VoxelPi/AX08/readme.md

# AX08
Design documents for the AX08 computer, an axiom architecture.

> [!CAUTION]
> The AX08 computer architecture is still highly experimental.
