VoxelPi/AX08/images/AX08.png

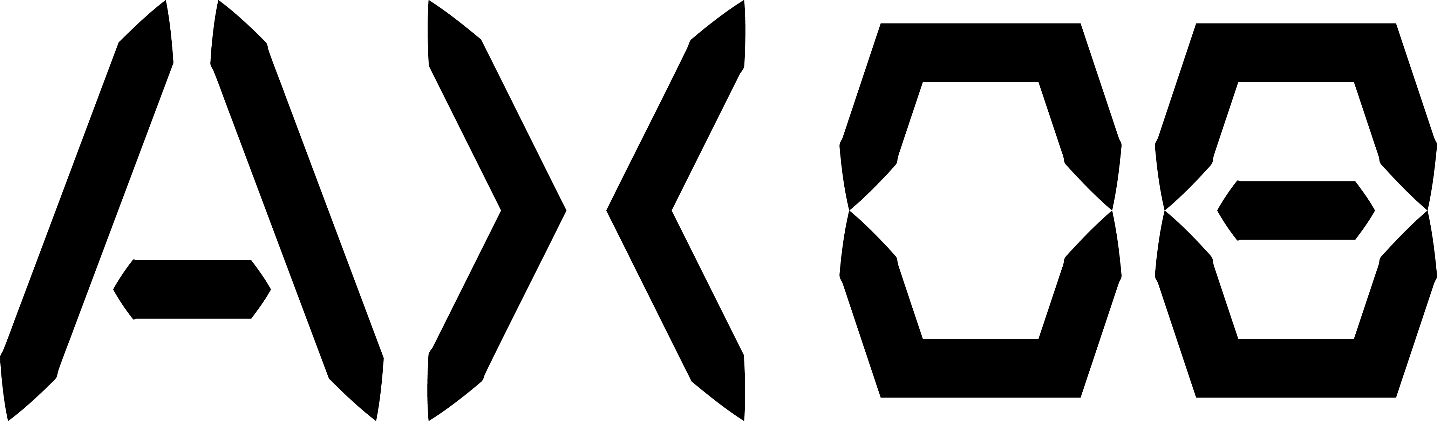
images/AX08.png
