VoxelPi/AX08/images/axiom.png

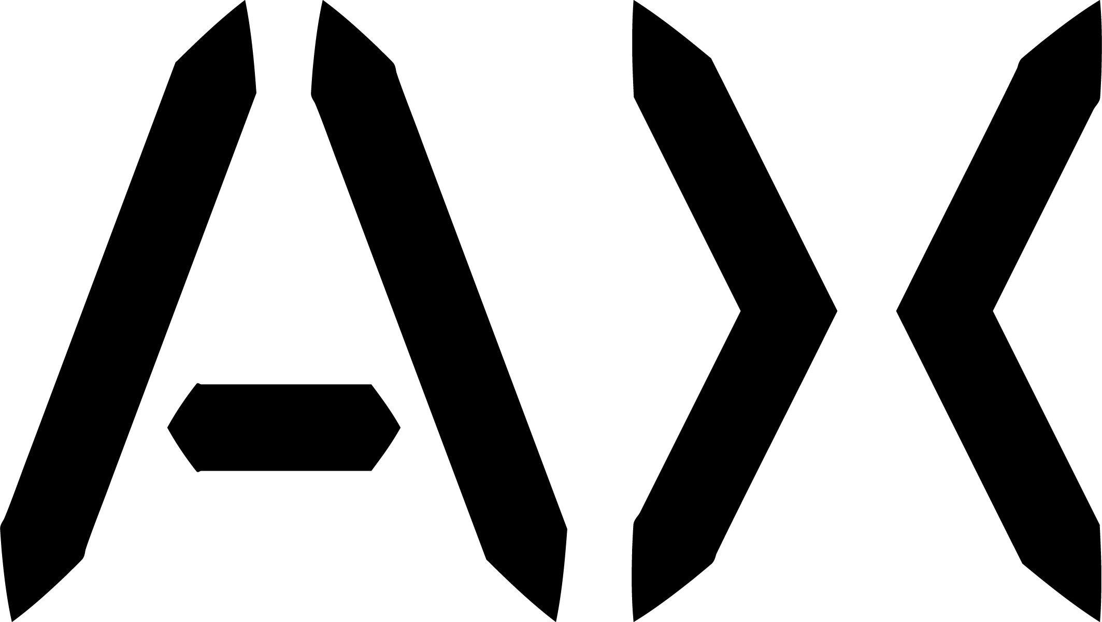
images/axiom.png
