VoxelPi/AX08/images/baud_rate.png

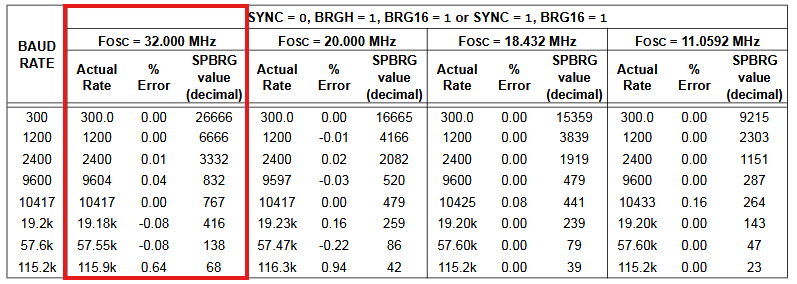
images/baud_rate.png
