VoxelPi/AX08/images/sequencer/sequencer_v0_clock_0_18kHz.png

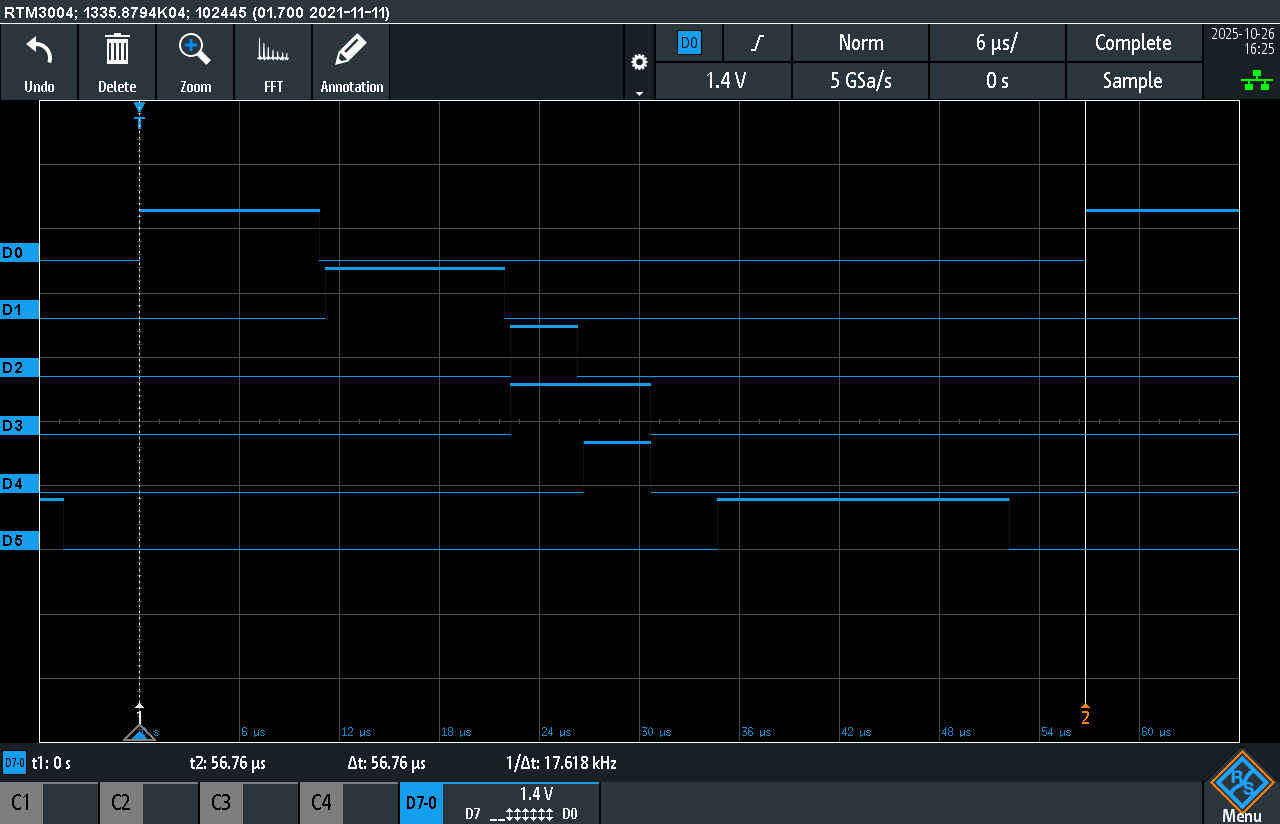
images/sequencer/sequencer_v0_clock_0_18kHz.png
