VoxelPi/AX08/images/sequencer/sequencer_v0_clock_1_7Hz.png

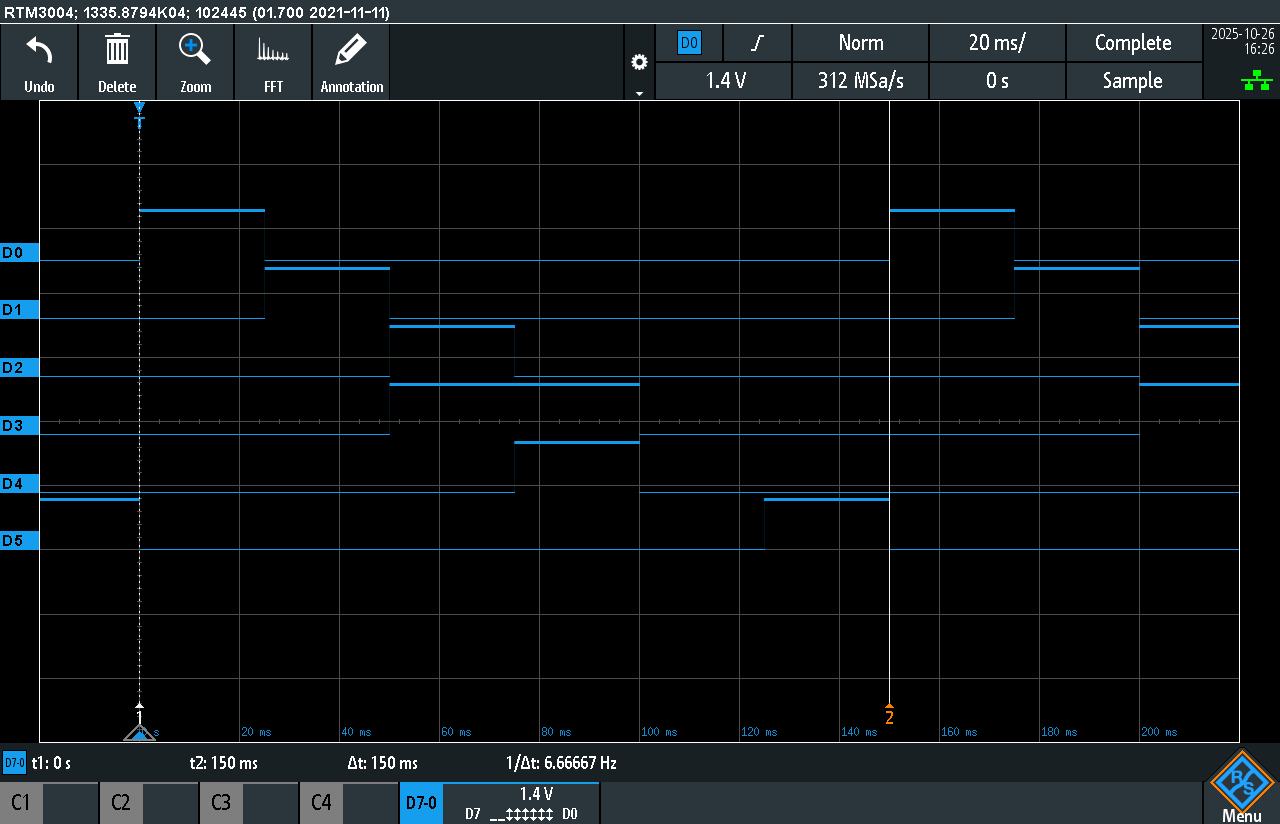
images/sequencer/sequencer_v0_clock_1_7Hz.png
