VoxelPi/AX08/images/sequencer/sequencer_v1_clock_0_20kHz.png

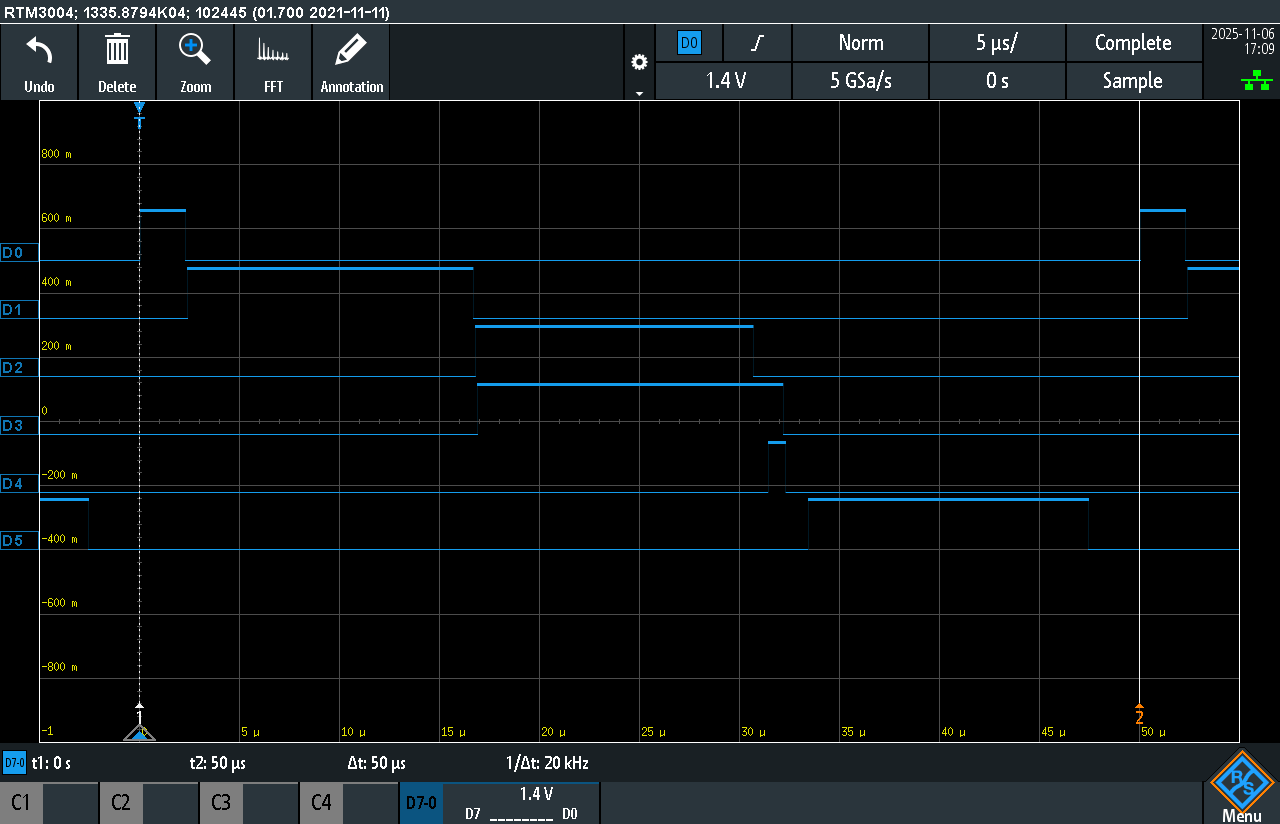
images/sequencer/sequencer_v1_clock_0_20kHz.png
