VoxelPi/AX08/images/sequencer/sequencer_v1_clock_1_1kHz.png

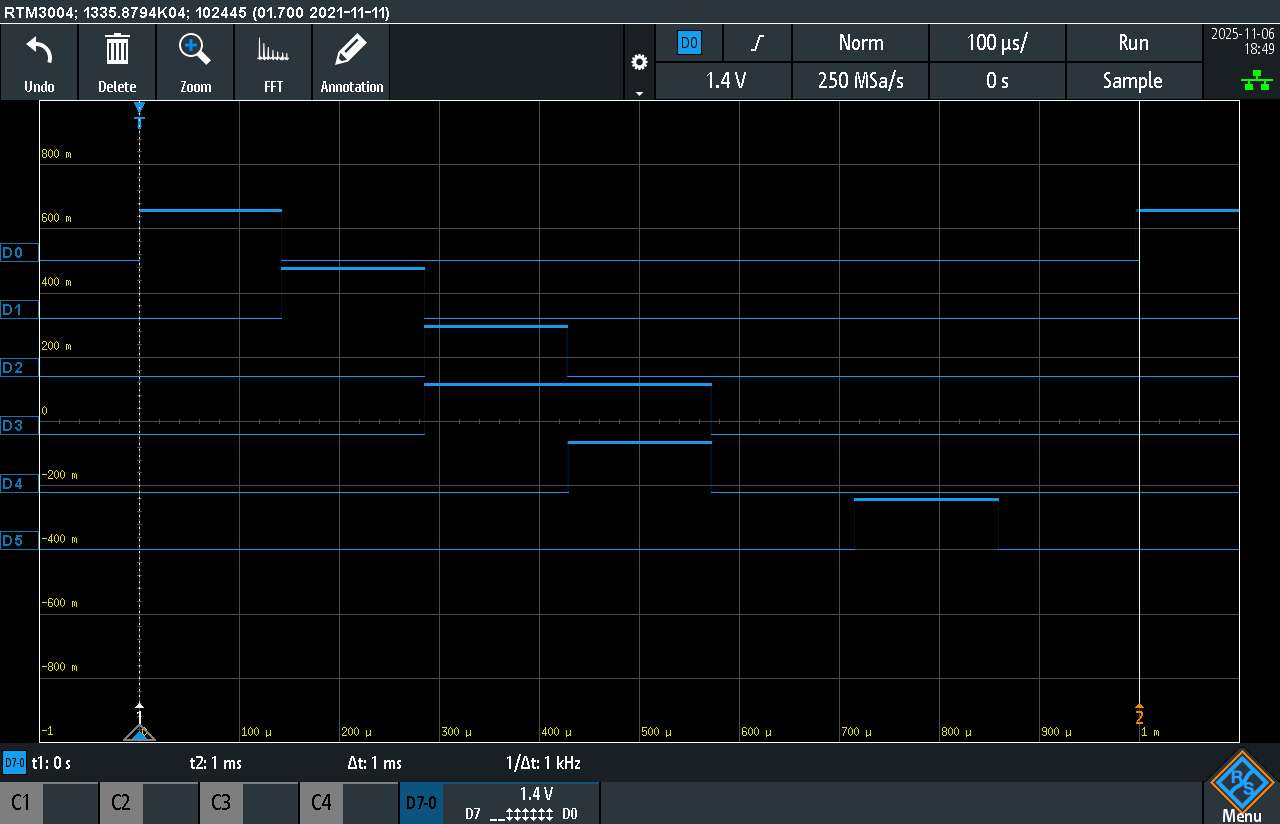
images/sequencer/sequencer_v1_clock_1_1kHz.png
