VoxelPi/AX08/images/sequencer_v0_timings.png

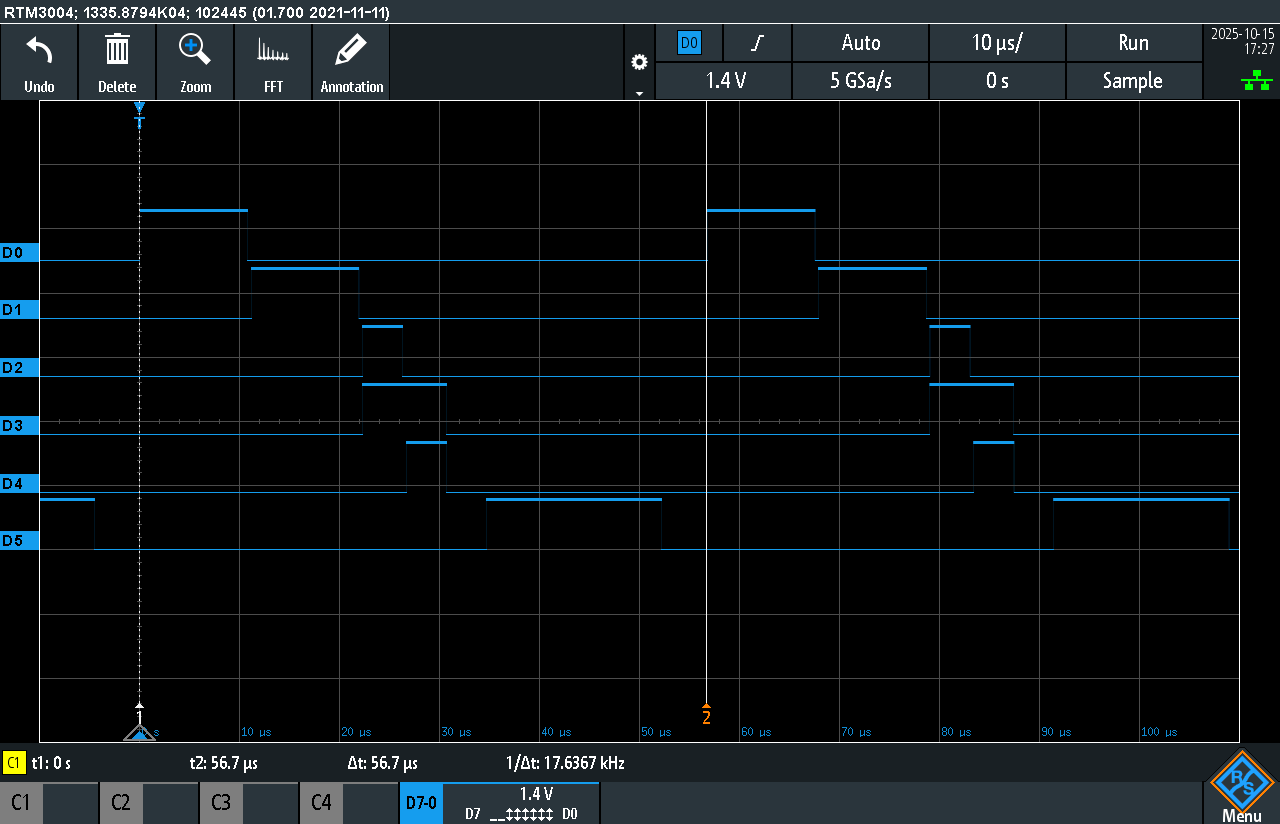
images/sequencer_v0_timings.png
