VoxelPi/AX08/schematic drafts/almost a stack.png

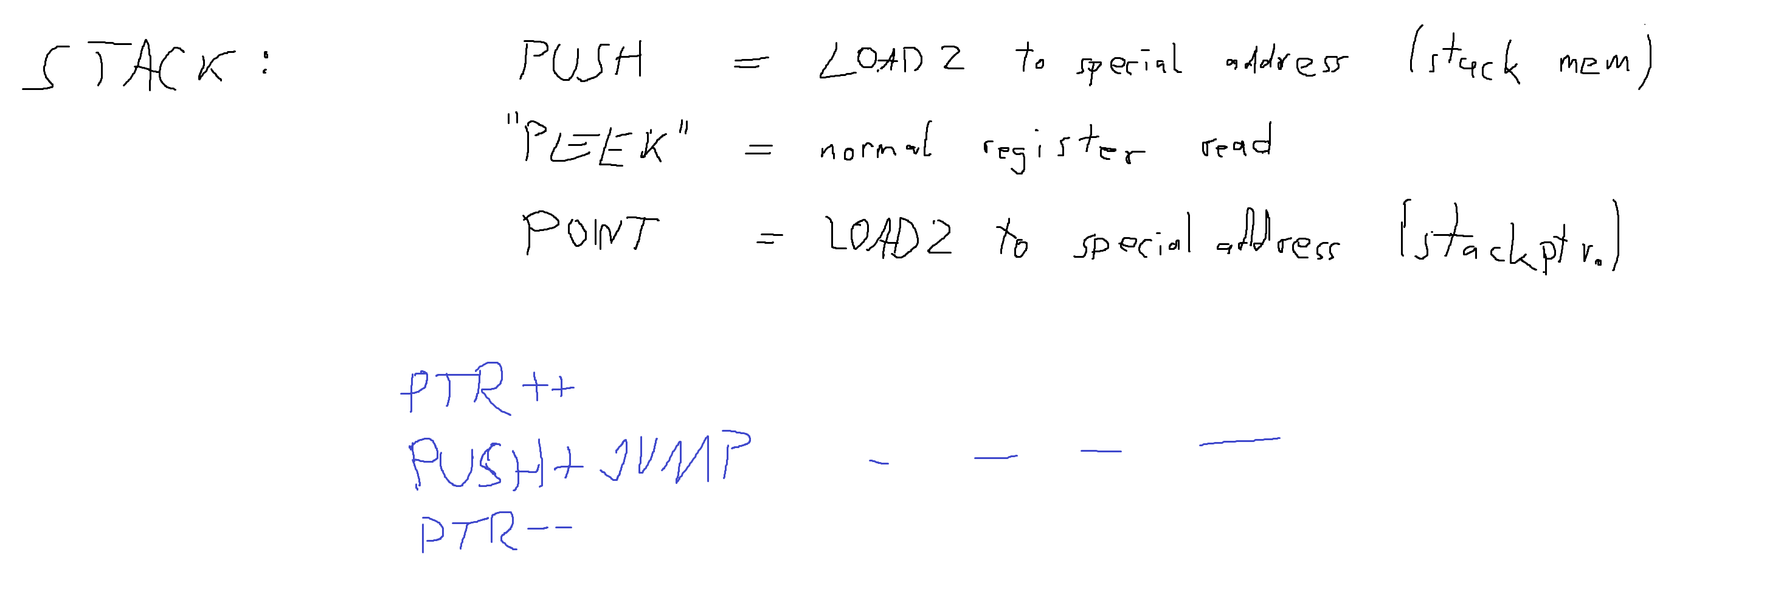
schematic drafts/almost a stack.png
