VoxelPi/AX08/schematic drafts/axiom_family.png

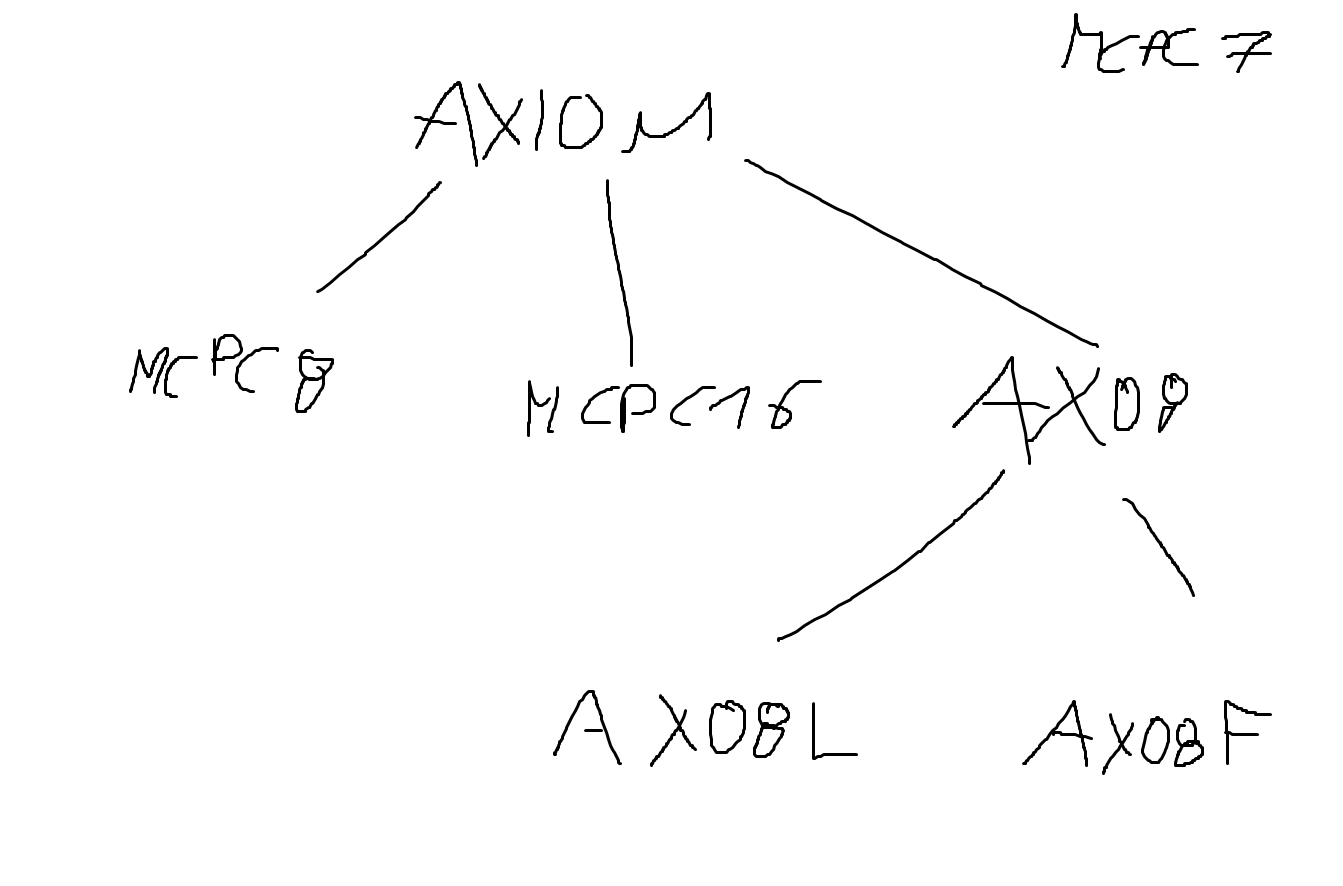
schematic drafts/axiom_family.png
