VoxelPi/AX08/schematic drafts/carry.exe.png

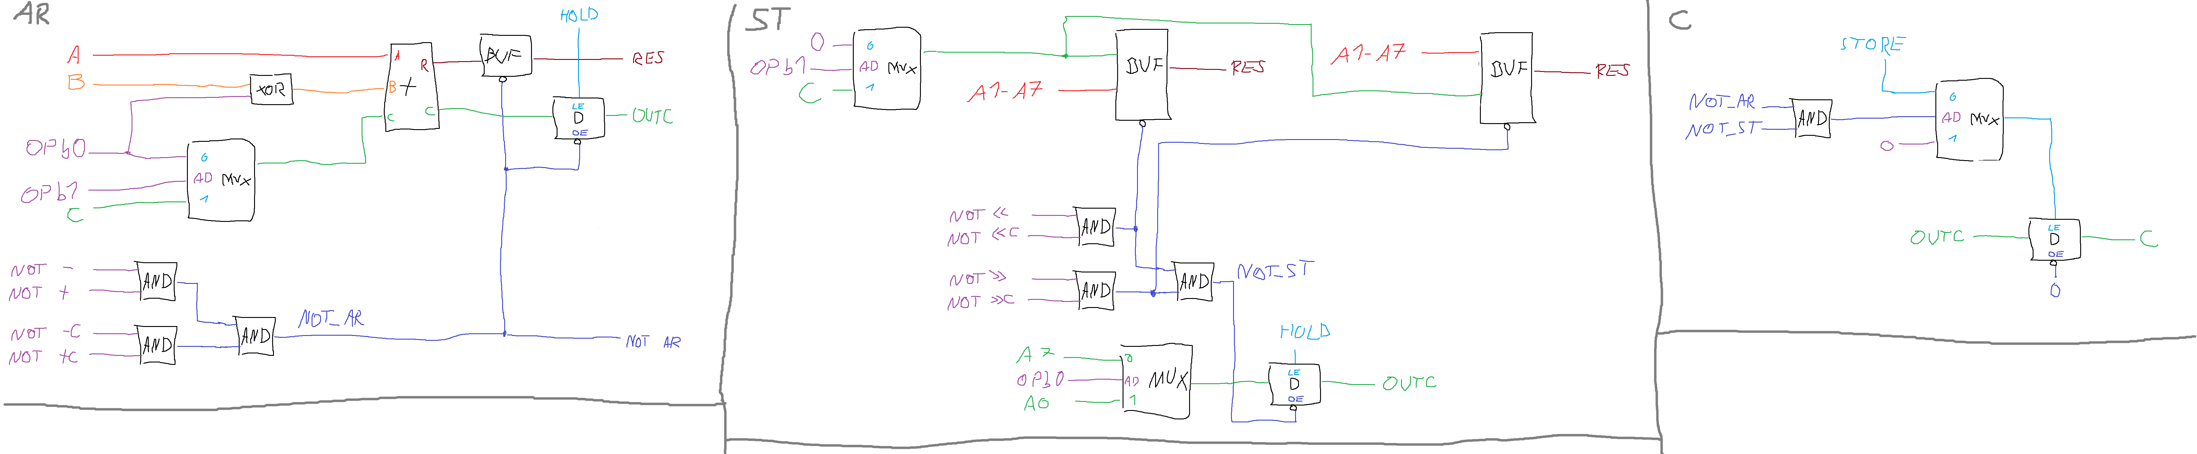
schematic drafts/carry.exe.png
