VoxelPi/AX08/schematic drafts/case_lid.png

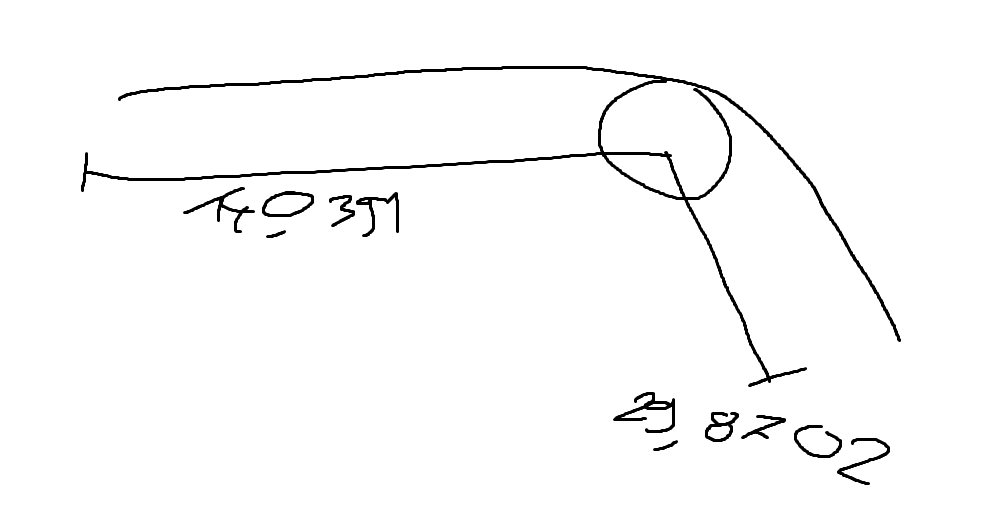
schematic drafts/case_lid.png
