VoxelPi/AX08/schematic drafts/fast_cycle.png

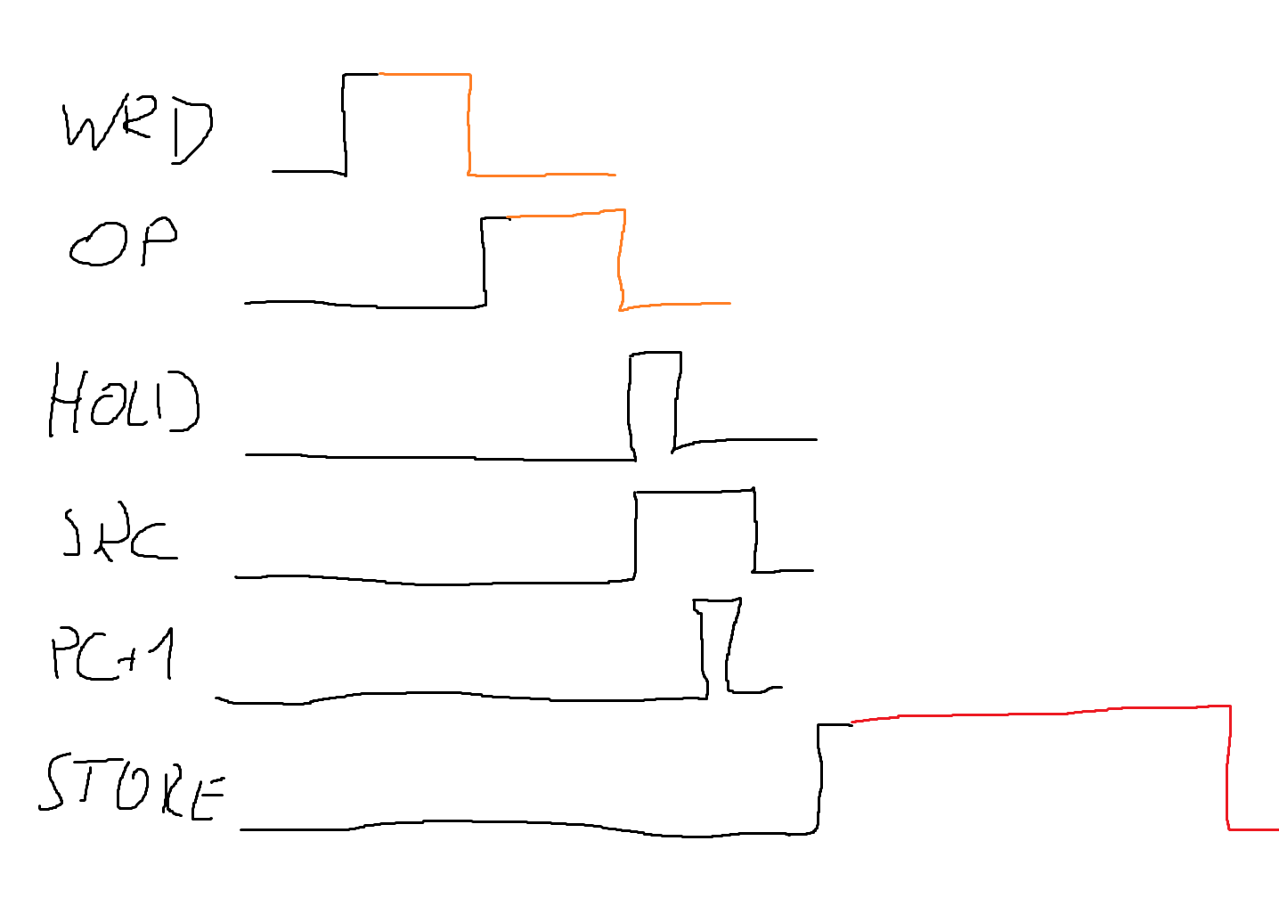
schematic drafts/fast_cycle.png
