VoxelPi/AX08/schematic drafts/frontpanel_v2.png

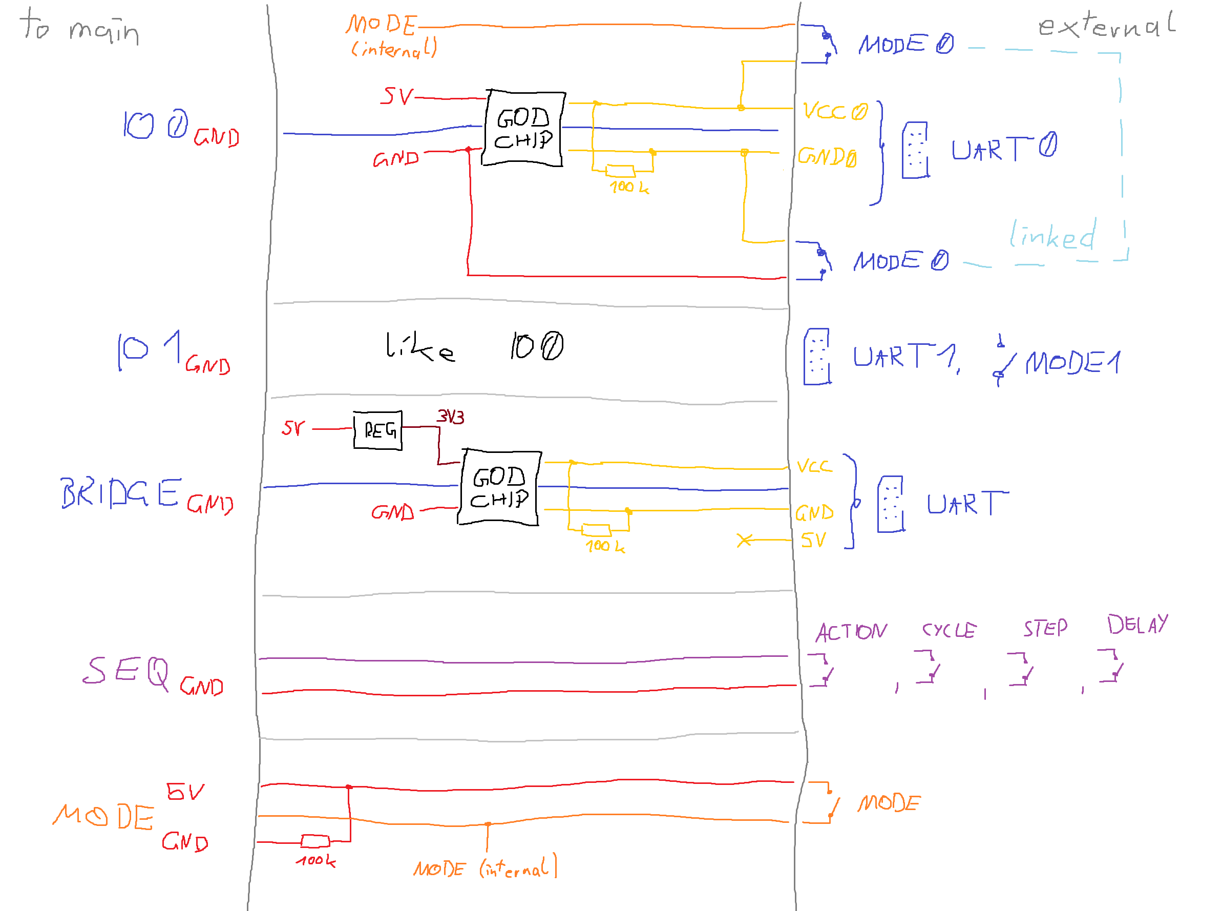
schematic drafts/frontpanel_v2.png
