VoxelPi/AX08/schematic drafts/general architecture.png

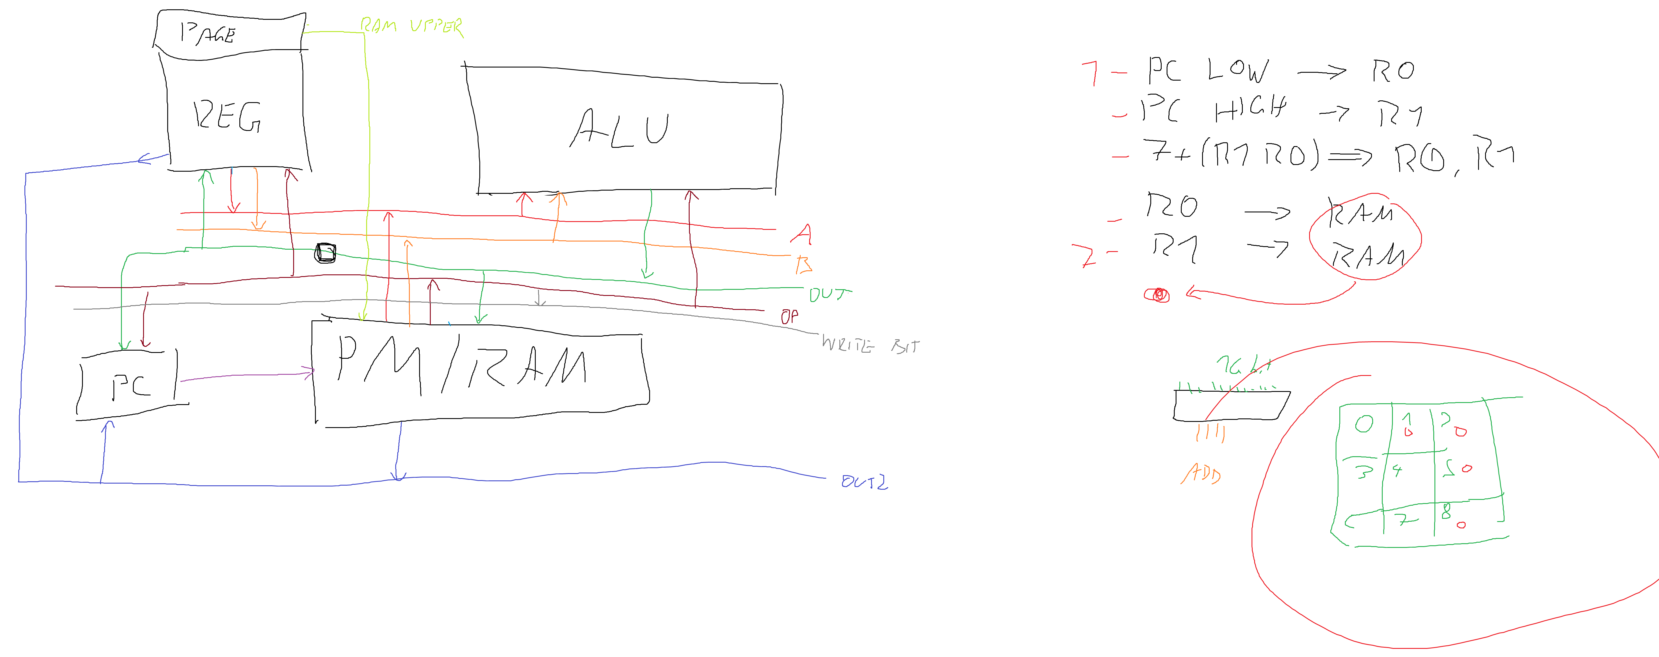
schematic drafts/general architecture.png
