VoxelPi/AX08/schematic drafts/hold unit.png

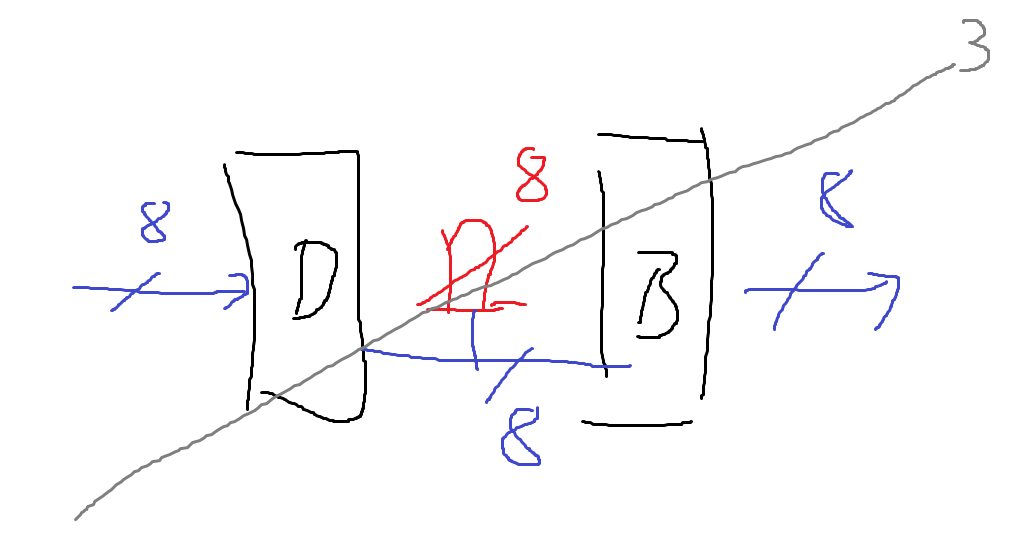
schematic drafts/hold unit.png
