VoxelPi/AX08/schematic drafts/io_unit.png

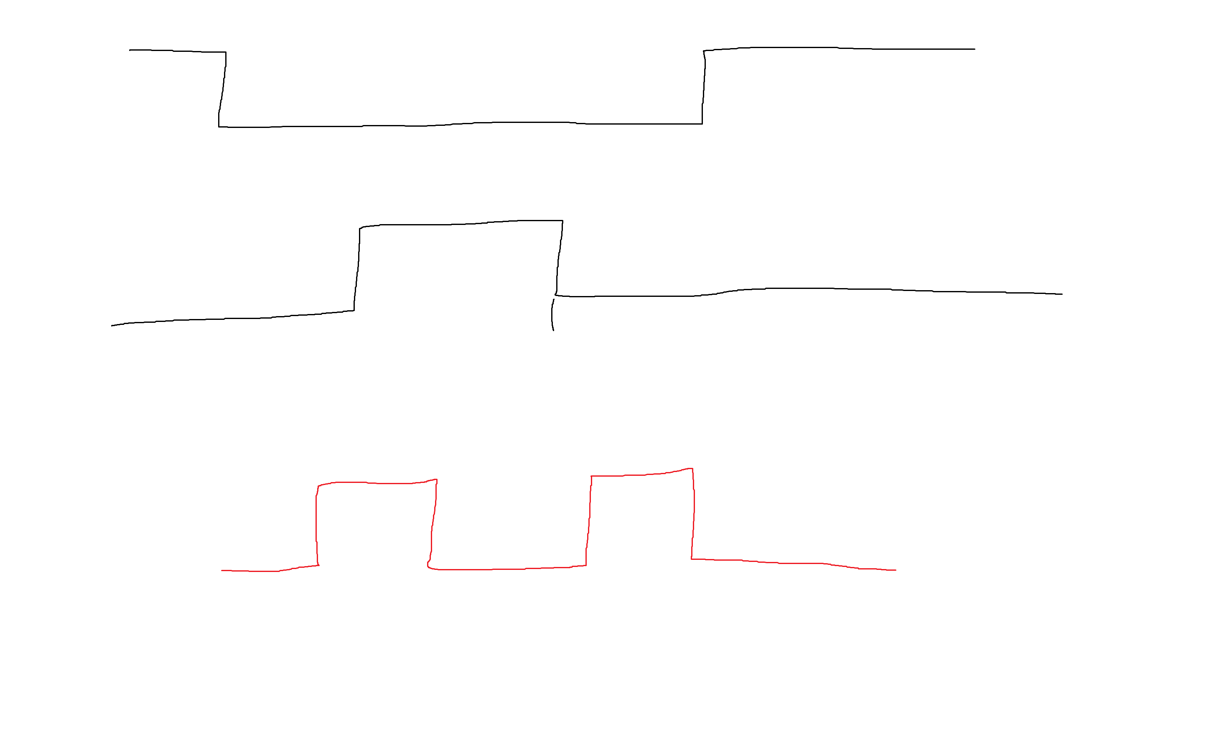
schematic drafts/io_unit.png
