VoxelPi/AX08/schematic drafts/io_unit_v2.png

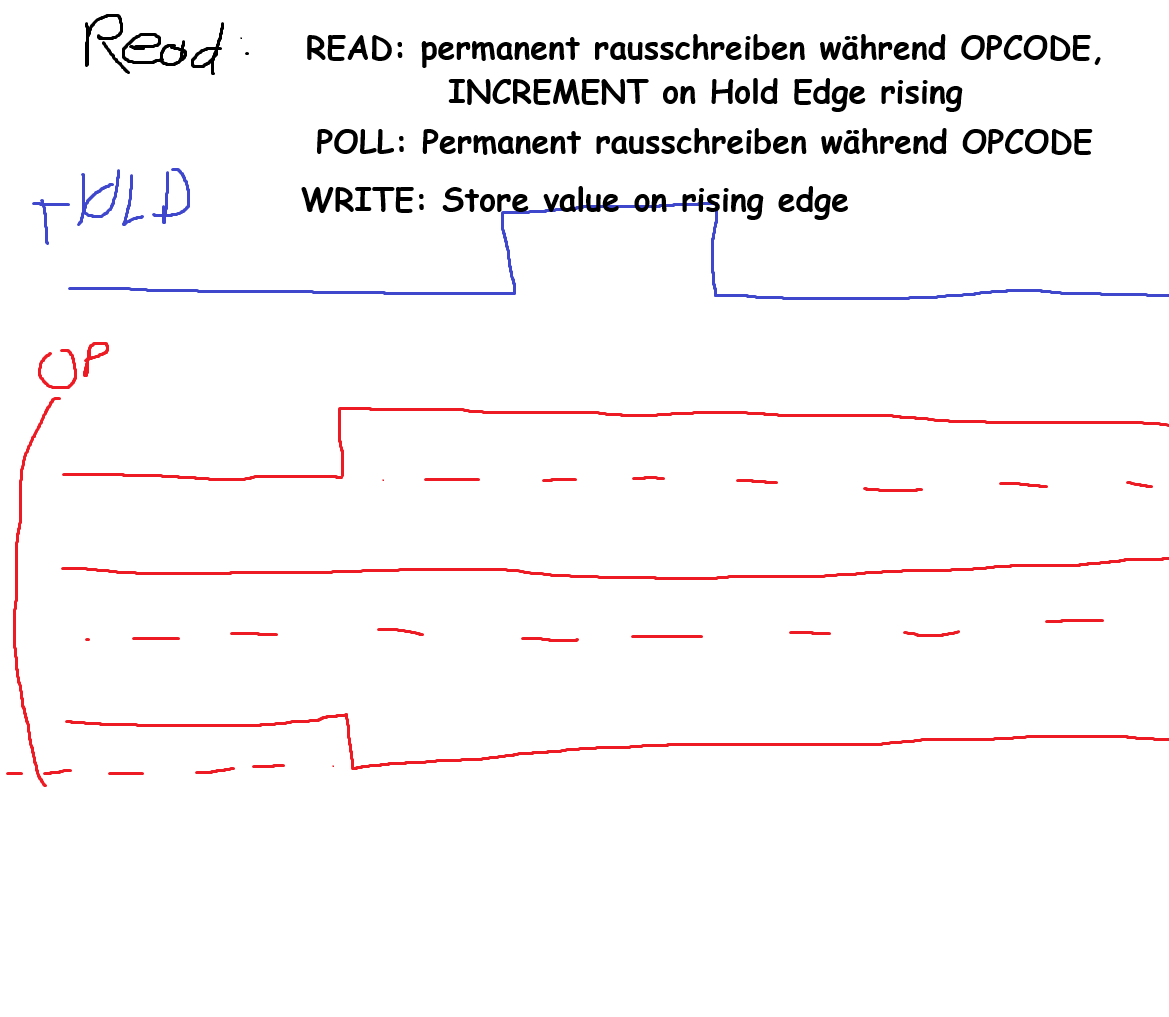
schematic drafts/io_unit_v2.png
