VoxelPi/AX08/schematic drafts/page.png

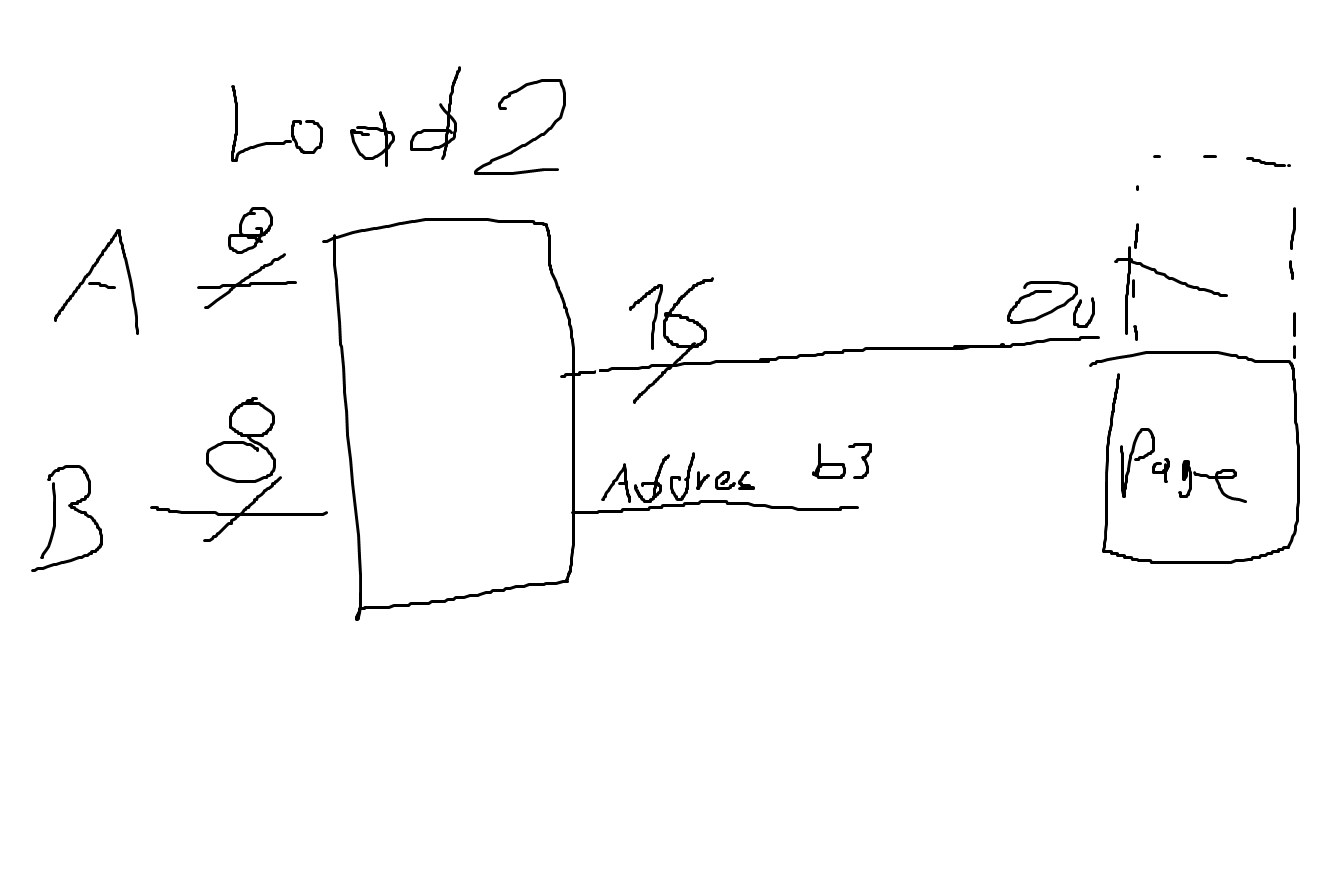
schematic drafts/page.png
