VoxelPi/AX08/schematic drafts/pc_address_logic.png

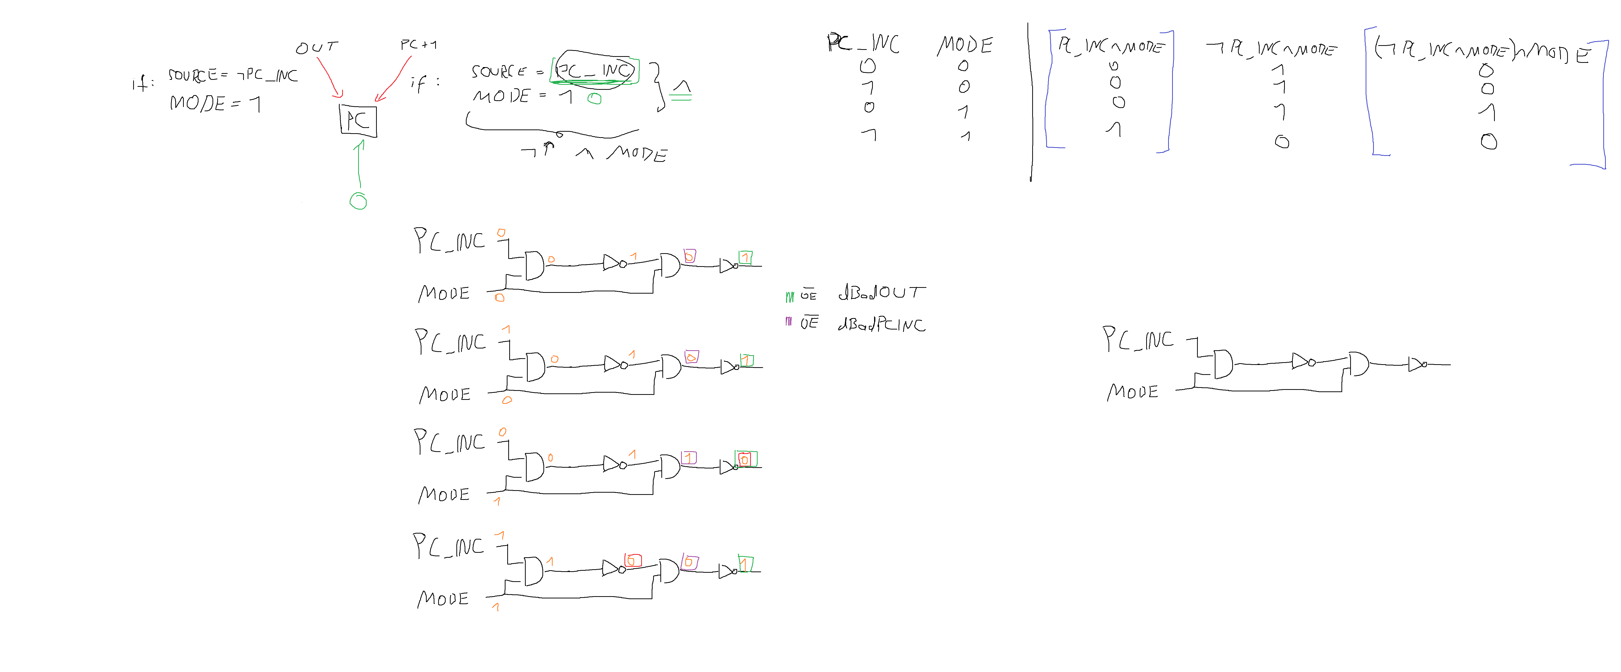
schematic drafts/pc_address_logic.png
