VoxelPi/AX08/schematic drafts/program_counter.png

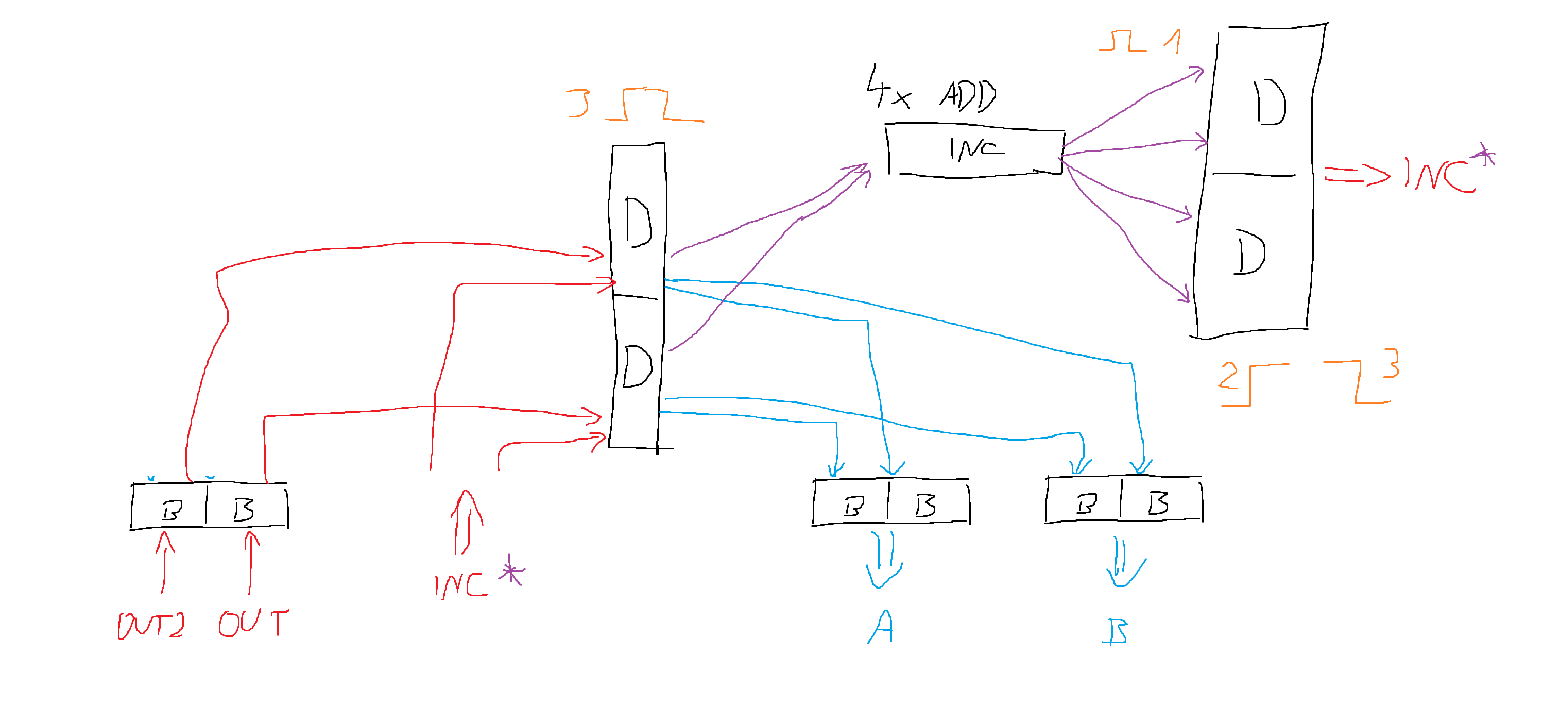
schematic drafts/program_counter.png
