VoxelPi/AX08/schematic drafts/sequencer_pinout_mainboard.png

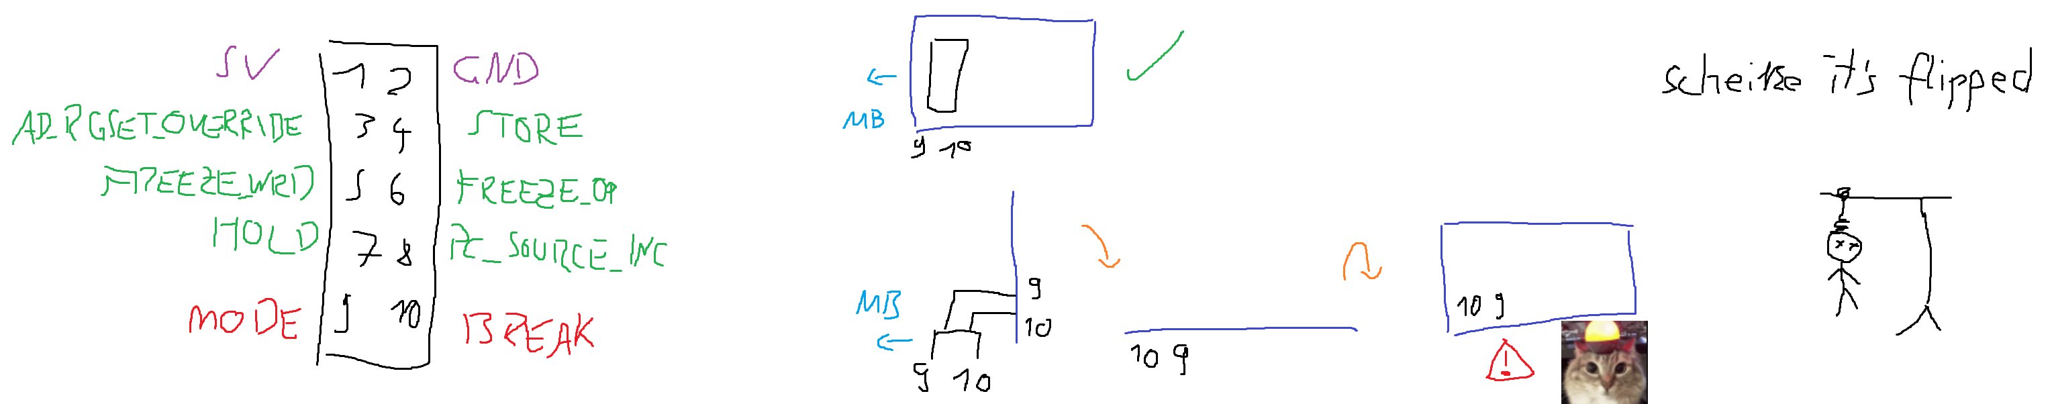
schematic drafts/sequencer_pinout_mainboard.png
