VoxelPi/AX08/schematic drafts/store logic.png

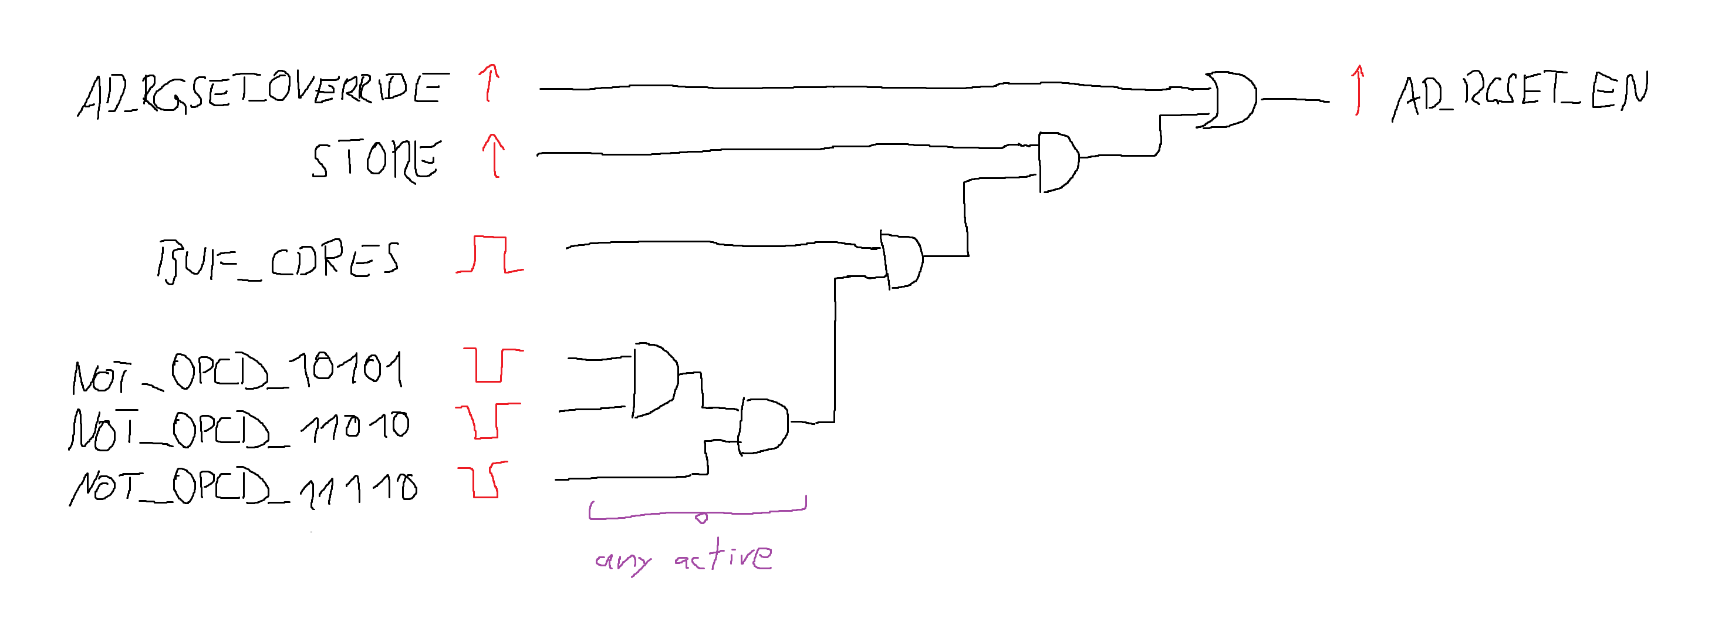
schematic drafts/store logic.png
