VoxelPi/AX08/schematic drafts/unit logic.png

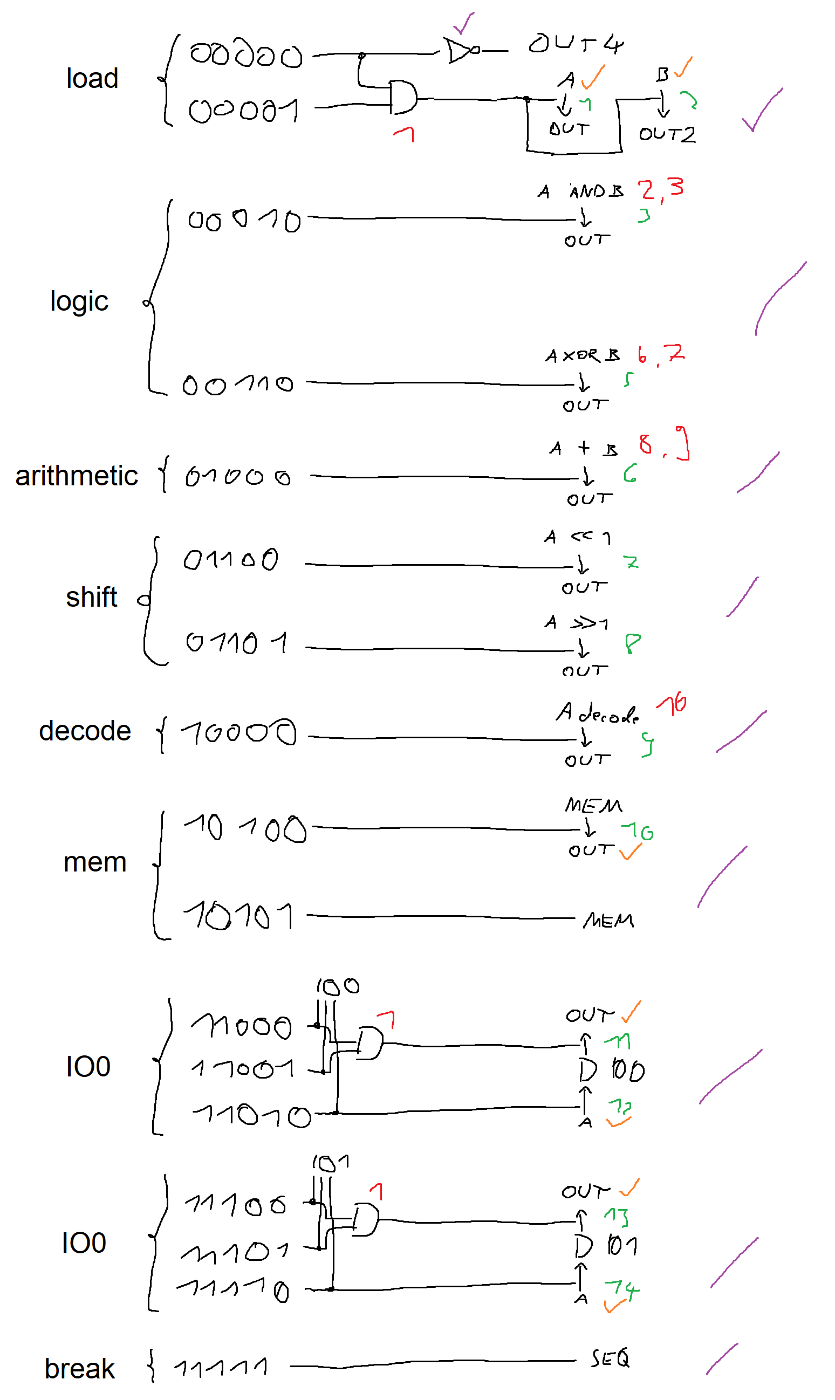
schematic drafts/unit logic.png
