VoxelPi/AX08/schematic drafts/Untitled2.png

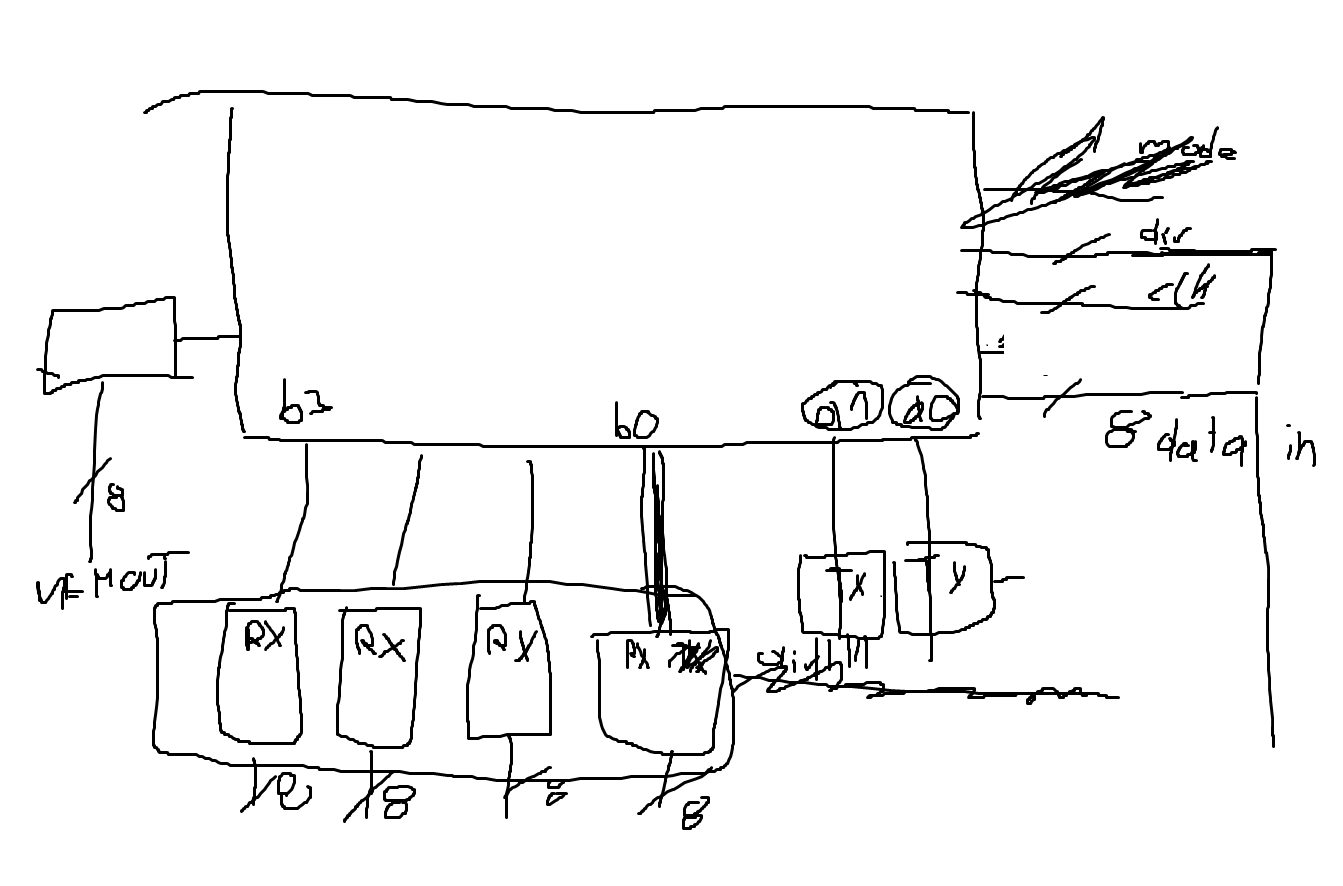
schematic drafts/Untitled2.png
