VoxelPi/AX08/schematic drafts/Untitled.png

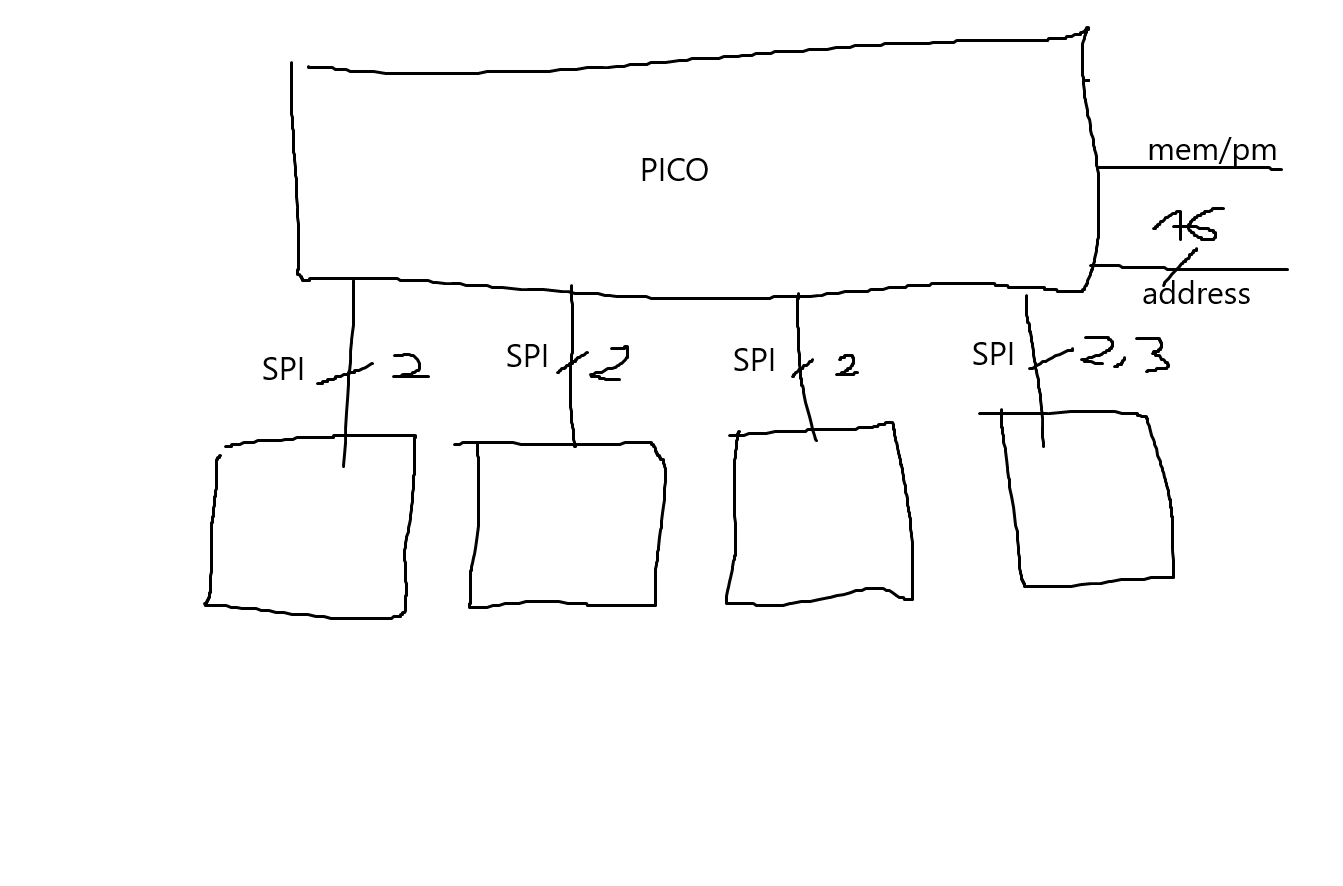
schematic drafts/Untitled.png
