VoxelPi/AX08/part count estimates.xlsx

Sheet: Tabelle1
 | Buffer | D Latch | PIC | Adder | MUX 8->1 | XOR 4x2in | OR 4x2in | AND 1x2in | NOT 4x1in | LED r 5mm | LED g 3mm | LED r 3mm | 10pin F | 10pin M 90 | xdxdxd
Register File | 24 | 8 | 4 | - | - | - | - | - | - | - | - | - | - | -
Debugger | 1 | - | - | - | - | - | - | - | - | 8 | - | - | 1 | 1
Program Counter | 6 | 4 | 1 | 4 | - | - | - | - | - | - | - | - | - | -
Hold unit | 3 | 3 | - | - | - | - | - | - | - | - | 16 | 8 | - | -
Condition unit | 1bit | 1bit | 1 | - | - | 1 | 2 | 1 | 1 | - | 1 | - | - | -
Load unit | 2 | - | 1 | - | - | - | - | - | - | - | - | - | - | -
IO unit | 2 | - | 1 | - | - | - | - | - | - | - | - | - | - | -
Arithmetic unit | 2 | - | 1 | 2 | 1 | - | - | - | - | - | - | - | - | -
Shift unit | 3 | - | 1 | - | 2 | - | - | - | - | - | - | - | - | -
Logic unit | 6 | - | 1 | - | - | - | - | - | - | - | - | - | - | - | 4x2 AND, OR, XOR, NAND, NOR, XNOR 2 each
SUM | 49 | 15 | 11 | 6 | 3 | 1 | 2 | 1 | 1 | 8 | 17 | 8 | 1 | 1

Sheet: notes
mem units (2): | m header 2x21 | 4 (5) | x
 | IC sockets pic | 20 (30) | x
 | pico "header" | 2 (2) | x
 | variety m header | 4pin (50pin) | x
 | resistors 0805!!! | book | no
 | capacitors 0805 | - | no
 | schottky | (?) | no
IO units (4): | m header 2x7 | 4 (5) | x
 | IC sockets pic | 4 (30) | x
 | variety m header | 8pin (50pin) | x
 | resistors 0805!!! | book | no
 | capacitors 0805 | - | no
sequencer (2): | m header 2x5 | 4 (5) | x
 | IC sockets pic | 2 (30) | x
 | variety m header | 4pin (50pin) | x
 | resistors 0805!!! | book | no
 | capacitors 0805 | - | no
 | buttons | 10 | x
 | switches | 10 | x
other: | breadboards | 10? | unavailable
 | IDC m header 2x4 | 4 | x
 | on/off switch | 2 | x
 | power switch | 2 | x
 | pin jumper | 100 | x
 | dc jack | 5 | x
mainboard: | resistors 0603 10k | 100? | x
 | capacitors 0805 | - | no
 | full adder | 20 | x
 | multiplexer | 5 | x
 | f header 2x21 | 4 (5) | x
 | f header 2x5 | 2 (5) | x
 | f header 2x7 | 4 (5) | x

Sheet: part_links
 |  |  |  |  | Total | Nur Peter | 10.80 €
 |  |  |  |  | 123.94 €
Type | Description | Amount | Price | Link
Raspberry Pico 2 | +2 für Peter | 4 | 5.40 € | https://www.mouser.at/ProductDetail/Raspberry-Pi/SC1632?qs=jcD%2FCkGBYeOeITPoQs%252BB3Q%3D%3D | 21.60 €
PIC16F1847 |  | 20 | 2.03 € | https://www.mouser.at/ProductDetail/Microchip-Technology/PIC16F1847-I-P?qs=opbZS4J%2Fiz0A7qhlWAt9Nw%3D%3D | 40.60 €
SN74HC245N | buffer | 55 | 0.32 € | https://lcsc.com/product-detail/Buffers-Drivers-Receivers-Transceivers_Texas-Instruments-SN74HC245N_C2899.html | 17.34 €
SN74LS373N(LX) | D latch | 20 | 0.38 € | https://lcsc.com/product-detail/Latches_lingxingic-SN74LS373N-LX_C22374106.html | 7.65 €
SN74LS283N(LX) | full adder | 10 | 0.28 € | https://lcsc.com/product-detail/Specialty-Logic_lingxingic-SN74LS283N-LX_C22374104.html | 2.76 €
SN74HC157N(LX) | multiplexer | 5 | 0.24 € | https://lcsc.com/product-detail/Signal-Switches-Multiplexers-Decoders_lingxingic-SN74HC157N-LX_C22436657.html | 1.21 €
SN74LS86AN(LX) | XOR | 5 | 0.15 € | https://lcsc.com/product-detail/Logic-Gates_lingxingic-SN74LS86AN-LX_C22466310.html | 0.75 €
SN74LS32N(LX) | OR | 5 | 0.19 € | https://lcsc.com/product-detail/Logic-Gates_lingxingic-SN74LS32N-LX_C22466295.html | 0.94 €
SN74LS08N(LX) | AND | 5 | 0.17 € | https://lcsc.com/product-detail/Logic-Gates_lingxingic-SN74LS08N-LX_C22384768.html | 0.85 €
SN74LS00N(LX) | NAND | 5 | 0.15 € | https://lcsc.com/product-detail/Logic-Gates_lingxingic-SN74LS00N-LX_C22374089.html | 0.77 €
SN74LS02N(LX) | NOR | 5 | 0.22 € | https://lcsc.com/product-detail/Logic-Gates_lingxingic-SN74LS02N-LX_C22374091.html | 1.10 €
CD4077BE(LX) | XNOR | 5 | 0.18 € | https://lcsc.com/product-detail/Logic-Gates_lingxingic-CD4077BE-LX_C24833629.html | 0.90 €
SN74LS04N(LX) | NOT | 10 | 0.20 € | https://lcsc.com/product-detail/Inverters_lingxingic-SN74LS04N-LX_C22374093.html | 2.01 €
DS1136-06-830SNV | breadboard | 5 | 1.38 € | https://lcsc.com/product-detail/PCBs-Breadboards_CONNFLY-Elec-DS1136-06-830SNV_C93726.html | 6.88 €
DY-333SDRD-SN-A3(EL)(HF) | LED red 5mm | 100 | 0.03 € | https://lcsc.com/product-detail/LED-Indication-Discrete_TONYU-DY-333SDRD-SN-A3-EL-HF_C7470717.html | 2.62 €
DY-204UYGD-H38-A3 | LED green 3mm | 200 | 0.02 € | https://lcsc.com/product-detail/LED-Indication-Discrete_TONYU-DY-204UYGD-H38-A3_C7470727.html | 4.76 €
LTL17KRH5D-012A | LED red 3mm | 100 | 0.04 € | https://lcsc.com/product-detail/LED-Indication-Discrete_Lite-On-LTL17KRH5D-012A_C7435538.html | 3.81 €
PM254-1-10-Z-8.5 | pin header 10 f | 10 | 0.13 € | https://lcsc.com/product-detail/Female-Headers_HCTL-PM254-1-10-Z-8-5_C2897373.html | 1.33 €
XFCN PZ254R-11-10P | pin header 10 m 90° | 10 | 0.05 € | https://lcsc.com/product-detail/Pin-Headers_XFCN-PZ254R-11-10P_C492418.html | 0.46 €
SN74LS244N(XBLW) | buffer for debugger | 12 | 0.22 € | https://lcsc.com/product-detail/Buffers-Drivers-Receivers-Transceivers_XBLW-SN74LS244N-XBLW_C42451381.html | 2.69 €
RC0805FR-072KL | resistor 2k 0805 | 200 | 0.0018 € | https://lcsc.com/product-detail/Chip-Resistor-Surface-Mount_YAGEO-RC0805FR-072KL_C114572.html | 0.36 €
CC0805KRX7R9BB104 | capacitor 100nF 0805 | 300 | 0.004 € | https://lcsc.com/product-detail/Multilayer-Ceramic-Capacitors-MLCC-SMD-SMT_YAGEO-CC0805KRX7R9BB104_C49678.html | 1.20 €
CL21B334KBFNNNE | capacitor 330nF 0805 | 50 | 0.01 € | https://lcsc.com/product-detail/Multilayer-Ceramic-Capacitors-MLCC-SMD-SMT_Samsung-Electro-Mechanics-CL21B334KBFNNNE_C73142.html | 0.49 €
2.54-2*4P | IDC connector | 5 | 0.07 € | https://lcsc.com/product-detail/IDC-Connectors_BOOMELE-Boom-Precision-Elec-2-54-2-4P_C9135.html | 0.36 €
IDC-265126-200-8P | IDC cable | 2 | 0.25 € | https://lcsc.com/product-detail/Dupont-wire-terminal-block-wire-electronic-wire_DEALON-IDC-265126-200-8P_C7465809.html | 0.51 €

Sheet: orders
Source | Description | Price | Buyer | total: | €0.00
 |  |  |  | Oliver: | €0.00
 |  |  |  | Peter: | €0.00
 |  |  |  | open: | €0.00

Sheet: orders 1
Source | Description | Price | Buyer | total: | €747.94
Mouser | PIC, Pico 2 | 74.64 € | Oliver | Oliver: | €656.89
JLC | Debugger | 6.98 € | Oliver | Peter: | €91.05
LCSC | initial | 82.72 € | Oliver | open: | €282.92
LCSC | supplements | 48.95 € | Oliver
JLC | lite + mem | 128.54 € | Oliver
Mouser | PICs, debug | 123.22 € | Oliver
Amazon | Netzteile | 15.38 € | Peter
Amazon | Steckbrett | 17.12 € | Peter
Amazon | Kabel+Devboards | 25.13 € | Peter
Amazon | 2 x Uart Adapter | 33.42 € | Peter
JLC | peripherals | 13.24 € | Oliver
JLC | main | 141.85 € | Oliver
JLC | frontpanel | 8.37 € | Oliver
LCSC | frontpanel | 28.38 € | Oliver
