VoxelPi/AX08/ax08.xlsx

Sheet: registers
address |  |  |  |  | register |  |  | description
value | b3 | b2 | b1 | b0 | READ | WRITE | COND.
0 | 0 | 0 | 0 | 0 | R0 | R0 | R0 | General purpose register
1 | 0 | 0 | 0 | 1 | R1 | R1 | R1 | General purpose register
2 | 0 | 0 | 1 | 0 | R2 | R2 | R2 | General purpose register
3 | 0 | 0 | 1 | 1 | R3 | R3 | R3 | General purpose register
4 | 0 | 1 | 0 | 0 | R4 | R4 | R4 | General purpose register
5 | 0 | 1 | 0 | 1 | R5 | R5 | R5 | General purpose register
6 | 0 | 1 | 1 | 0 | R6 | R6 | R6 | General purpose register
7 | 0 | 1 | 1 | 1 | R7 | R7 | R7 | General purpose register
8 | 1 | 0 | 0 | 0 | PC_0 | PC |  | Bits 0..7 of the program counter
9 | 1 | 0 | 0 | 1 | PC_1 |  |  | Bits 8..15 of the program counter
10 | 1 | 0 | 1 | 0 |  | PAGE
11 | 1 | 0 | 1 | 1 | PAGE |  |  | Bits 8..15 of the memory address
12 | 1 | 1 | 0 | 0 | STPTR_0 | STPTR |  | Bits 0..7 of the Stack Pointer
13 | 1 | 1 | 0 | 1 | STPTR_1 |  |  | Bits 8..15 of the Stack Pointer
14 | 1 | 1 | 1 | 0
15 | 1 | 1 | 1 | 1

Sheet: instructions
 | 31 | 30 | 29 | 28 | 27 | 26 | 25 | 24 | 23 | 22 | 21 | 20 | 19 | 18 | 17 | 16 | 15 | 14 | 13 | 12 | 11 | 10 | 9 | 8 | 7 | 6 | 5 | 4 | 3 | 2 | 1 | 0
 | OPERATION [0:4] |  |  |  |  | CONDITION [0:2] |  |  | CONDITION ADDRESS [0:2] |  |  | OUTPUT ADDRESS [0:2] |  |  | MODE B | MODE A | B [0:7] |  |  |  |  |  |  |  | A [0:7]
MODE | Bit
 | 7 | 6 | 5 | 4 | 3 | 2 | 1 | 0
0 | immediate value [0:7]
1 |  |  |  |  | register address [0:3]

Sheet: operations
OPCODE |  |  |  |  |  | Unit | Operation | bus values |  |  | Carry | description
value | b4 | b3 | b2 | b1 | b0 |  |  | A | B | Output
0 | 0 | 0 | 0 | 0 | 0 | LOAD | LOAD 2 | value [0..7] | value [8..15] | value | UNCHANGED | Writes the combined 16bit value to the selected special function register
1 | 0 | 0 | 0 | 0 | 1 |  | LOAD | value | UNUSED |  | UNCHANGED | Writes the value to the selected output register
2 | 0 | 0 | 0 | 1 | 0 | LOGIC | A and B | input A | input B | result | UNCHANGED | Calculates the given logical combination of A and B and stores the result
3 | 0 | 0 | 0 | 1 | 1 |  | A nand B
4 | 0 | 0 | 1 | 0 | 0 |  | A or B
5 | 0 | 0 | 1 | 0 | 1 |  | A nor B
6 | 0 | 0 | 1 | 1 | 0 |  | A xor B
7 | 0 | 0 | 1 | 1 | 1 |  | A xnor B
8 | 0 | 1 | 0 | 0 | 0 | ARITHMETIC | A + B | input A | input B | result | MODIFIED | Performs the given arithmetic operation and returns the result. C_in is the state of the carry flag. The state of the carry flag is updated after the calculation
9 | 0 | 1 | 0 | 0 | 1 |  | A - B
10 | 0 | 1 | 0 | 1 | 0 |  | A + B + C_in
11 | 0 | 1 | 0 | 1 | 1 |  | A - B - (1 - C_in)
12 | 0 | 1 | 1 | 0 | 0 | SHIFT | A SHIFT LEFT | input | UNUSED | result | MODIFIED | Shifts all bits one to the left. Bit 0 is cleared. The previous content of bit 7 is copied to the carry flag
13 | 0 | 1 | 1 | 0 | 1 |  | A SHIFT RIGHT |  |  |  |  | Shifts all bits one to the right. Bit 7 is cleared. The previous content of bit 0 is copied to the carry flag
14 | 0 | 1 | 1 | 1 | 0 |  | A ROTATE LEFT |  |  |  |  | Shifts all bits one to the left. Bit 0 is set to the old carry flag and the carry flag is set to the old bit 7
15 | 0 | 1 | 1 | 1 | 1 |  | A ROTATE RIGHT |  |  |  |  | Shifts all bits one to the right. Bit 7 is set to the old carry flag and the carry flag is set to the old bit 0
16 | 1 | 0 | 0 | 0 | 0 | DECODE | NDECODE | value [0..2] | UNUSED | result | UNCHANGED | Decodes Bit 0 - Bit 2 of input, upper bits unused. Output is active low
17 | 1 | 0 | 0 | 0 | 1 |  | DECODE | value [0..2] |  |  |  | Decodes Bit 0 - Bit 2 of input, upper bits unused. Output is active high
18 | 1 | 0 | 0 | 1 | 0
19 | 1 | 0 | 0 | 1 | 1
20 | 1 | 0 | 1 | 0 | 0 | MEMORY | LOAD | address [0..7] | UNUSED | value | UNCHANGED | Loads the value at the given address and writes it to the output
21 | 1 | 0 | 1 | 0 | 1 |  | STORE | address [0..7] | value | DISABLED | UNCHANGED | Stores the given value at the given memory address
22 | 1 | 0 | 1 | 1 | 0
23 | 1 | 0 | 1 | 1 | 1
24 | 1 | 1 | 0 | 0 | 0 | IO_0 | POLL | UNUSED | UNUSED | input available | UNCHANGED | Returns 1 if a new value is available from UART unit, otherwise returns 0
25 | 1 | 1 | 0 | 0 | 1 |  | READ | UNUSED | UNUSED | last received value | UNCHANGED | Copies the value from the UART unit and returns it
26 | 1 | 1 | 0 | 1 | 0 |  | WRITE | value | UNUSED | DISABLED | UNCHANGED | Writes the value to the UART unit
27 | 1 | 1 | 0 | 1 | 1
28 | 1 | 1 | 1 | 0 | 0 | IO_1 | POLL | UNUSED | UNUSED | input available | UNCHANGED | Returns 1 if a new value is available from UART unit, otherwise returns 0
29 | 1 | 1 | 1 | 0 | 1 |  | READ | UNUSED | UNUSED | last received value | UNCHANGED | Copies the value from the UART unit and returns it
30 | 1 | 1 | 1 | 1 | 0 |  | WRITE | value | UNUSED | DISABLED | UNCHANGED | Writes the value to the UART unit
31 | 1 | 1 | 1 | 1 | 1 | BREAK | BREAK | UNUSED | UNUSED | DISABLED | UNCHANGED | Causes the computer to enter a breakpoint

Sheet: operations_lite
OPCODE |  |  |  |  |  | Unit | Operation | bus values |  |  | description
value | b4 | b3 | b2 | b1 | b0 |  |  | A | B | Output
0 | 0 | 0 | 0 | 0 | 0 | LOAD | LOAD 2 | value [0..7] | value [8..15] | value [0..7] | Writes the combined 16bit value to the PC
1 | 0 | 0 | 0 | 0 | 1 |  | LOAD | value | UNUSED | value | Writes the value to the output
2 | 0 | 0 | 0 | 1 | 0 | LOGIC | A and B | input A | input B | result | Calculates the given logical combination of A and B and stores the result
3 | 0 | 0 | 0 | 1 | 1
4 | 0 | 0 | 1 | 0 | 0
5 | 0 | 0 | 1 | 0 | 1
6 | 0 | 0 | 1 | 1 | 0 |  | A xor B
7 | 0 | 0 | 1 | 1 | 1
8 | 0 | 1 | 0 | 0 | 0 | ARITHMETIC | A + B | input A | input B | result | Performs the given arithmetic operation and returns the result. C_in is the state of the carry flag. The state of the carry flag is updated after the calculation.
9 | 0 | 1 | 0 | 0 | 1
10 | 0 | 1 | 0 | 1 | 0
11 | 0 | 1 | 0 | 1 | 1
12 | 0 | 1 | 1 | 0 | 0 | SHIFT | A SHIFT LEFT | input | UNUSED | result | Shifts all bits one to the left. Bit 0 is cleared. The previous content of bit 7 is copied to the carry flag
13 | 0 | 1 | 1 | 0 | 1 |  | A SHIFT RIGHT |  |  |  | Shifts all bits one to the right. Bit 7 is cleared. The previous content of bit 0 is copied to the carry flag
14 | 0 | 1 | 1 | 1 | 0
15 | 0 | 1 | 1 | 1 | 1
16 | 1 | 0 | 0 | 0 | 0 | DECODE | NDECODE | value [0..2] | UNUSED | result | Decodes Bit 0 - Bit 2 of input, upper bits unused.
17 | 1 | 0 | 0 | 0 | 1
18 | 1 | 0 | 0 | 1 | 0
19 | 1 | 0 | 0 | 1 | 1
20 | 1 | 0 | 1 | 0 | 0 | MEMORY | LOAD | address [0..7] | UNUSED | value | Loads the value at the given address and writes it to the output
21 | 1 | 0 | 1 | 0 | 1 |  | STORE | address [0..7] | value | DISABLED | Stores the given value at the given address
22 | 1 | 0 | 1 | 1 | 0
23 | 1 | 0 | 1 | 1 | 1
24 | 1 | 1 | 0 | 0 | 0 | IO_0 | POLL | UNUSED | UNUSED | input available | Returns 1 if a new value is available from UART unit, otherwise returns 0.
25 | 1 | 1 | 0 | 0 | 1 |  | READ | UNUSED | UNUSED | last received value | Copies the value from the UART unit and returns it.
26 | 1 | 1 | 0 | 1 | 0 |  | WRITE | value | UNUSED | DISABLED | Writes the value to the UART unit.
27 | 1 | 1 | 0 | 1 | 1
28 | 1 | 1 | 1 | 0 | 0 | IO_1 | POLL | UNUSED | UNUSED | input available | Returns 1 if a new value is available from UART unit, otherwise returns 0.
29 | 1 | 1 | 1 | 0 | 1 |  | READ | UNUSED | UNUSED | last received value | Copies the value from the UART unit and returns it.
30 | 1 | 1 | 1 | 1 | 0 |  | WRITE | value | UNUSED | DISABLED | Writes the value to the UART unit.
31 | 1 | 1 | 1 | 1 | 1 | BREAK | BREAK | UNUSED | UNUSED | OVERRIDDEN | Causes the computer to enter a breakpoint.

Sheet: condition
mode |  |  |  | register
value | b2 | b1 | b0
0 | 0 | 0 | 0 | always
1 | 0 | 0 | 1 | never
2 | 0 | 1 | 0 | R = 0
3 | 0 | 1 | 1 | R != 0
4 | 1 | 0 | 0 | R < 0
5 | 1 | 0 | 1 | R >= 0
6 | 1 | 1 | 0 | R > 0
7 | 1 | 1 | 1 | R <= 0

Sheet: bus
Bus | Bit
 | 15 | 14 | 13 | 12 | 11 | 10 | 9 | 8 | 7 | 6 | 5 | 4 | 3 | 2 | 1 | 0
OPERATION |  |  |  |  |  |  |  |  | active | init | carry | opcode [0:4]
A |  |  |  |  |  |  |  |  | value [0..7]
B |  |  |  |  |  |  |  |  | value [0..7]
C |  |  |  |  |  |  |  |  | value [0..7]
OUT | value [0..15]
EXTRA |  |  |  |  |  |  |  |  |  |  |  |  |  | carry | has carry | no write

Sheet: cycle
STEP | Description | Net action | FREEZE INSTR. | FREEZE OP | HOLD | PC_SOURCE_INC | AD_RGSET_OVERRIDE | STORE
FREEZE WORD | Freeze A Immediate value / A address, B immediate value / B address, OUT address, condition result | FREEZE_WRD ↑
FREEZE OP | Freezes OPCODE, will be set to 0 if condition is false | FREEZE_OP ↑, (FREEZE_WRD ↓)
HOLD OUTPUT | Freezes register side output bus | HOLD ↑, (FREEZE_OP ↓)
PRE INCREMENT |  | PC_SOURCE_INC ↑, HOLD ↓
INCREMENT | Increments PC | AD_RGSET_OVERRIDE ↑,
PRE STORE | Switch output address to OUT address | PC_SOURCE_INC ↓, AD_RGSET_OVERRIDE ↓
STORE | Stores output to register | STORE ↑
RESET | Switch output address to OUT address | STORE ↓ (all ↓)

Sheet: memory
Address space
program | memory
 | 0x0000 | RAM
 | …
 | 0x7FFF
0x0000 |  | PM
…
0x7FFF
0x8000 | 0x8000
… | …
0xFFFF | 0xFFFF

Sheet: seq-brg protocol
BIT | DIRECTION
 | BRIDGE → SEQUENCER | SEQUENCER → BRIDGE
0 | RESPOND (1 = send packet to bridge) | OPERATING STATE
1 | ENABLE (0 = STOP, 1 = RUNNING)
2 | SEQUENCER COMMAND | CYCLE STATE
3
4
5
6
7 |  | reason
INDEX | SEQUENCER COMMAND
0 | No action
1 | Reset
2 | Continue
3 | Step Instruction
4 | Step Cycle
5
6
7
INDEX | OPERATING STATE
0 | Stopped
1 | Running
2 | Halted
3 | undefined
INDEX | CYCLE STATE
0 | FREEZE WORD
1 | FREEZE OP
2 | HOLD OUTPUT
3 | INCREMENT
4 | PRE STORE
5 | STORE
6 | undefined
7 | undefined
