VoxelPi/AX08/(list of files, cad)

Other CAD files:
hardware/case/ax08_bracket.prt
hardware/case/ax08_tray.prt
hardware/case/cable_anchor_v2.prt
hardware/case/cable_holder.prt
hardware/case/cable_holder_test.prt
hardware/case/case_back.prt
hardware/case/case_left.prt
hardware/case/case_right.prt
hardware/case/din912.prt
hardware/case/front_bottom.prt
hardware/case/frontpanel_backplate.prt
hardware/case/lid_frame_back.prt
hardware/case/lid_frame_front.prt
hardware/case/lid_frame_left.prt
hardware/case/lid_frame_right.prt
hardware/case/lid_glass.prt
hardware/case/lid_glass_backup.prt
hardware/case/lid_glass_cut_template.prt
hardware/case/pcb_ax08_placeholder.prt
hardware/case/pcb_ax08_placeholder_bck.prt
hardware/case/pcb_frontpanel_placeholder.prt
hardware/case/pcb_io_unit_placeholder.prt
hardware/case/prt0005.prt
hardware/case/util/rohr.prt
