VoxelPi/AX08/schematic drafts/ax08lite silicon errata.docx

break instruction induces store (forgor to wire to store logic)

page register write address is set as 11 (11 is the correct read address, write address should be 10)

decode always returns 0xFF if bit 3 of A is not zero (should return active low decode value of bits 0-2 of A)
