VoxelPi/AX08/(list of files, drawings)

Other design files:
easyeda/ax08.eprj
easyeda/ax08_doc.eprj
