VoxelPi/AX08/firmware/ax08-bridge/src/ax08/bridge/protocol.c

#include "protocol.h"

#include "hardware/dma.h"
#include "hardware/uart.h"
#include "pico/sha256.h"
#include "pico/stdlib.h"

#include <stdint.h>
#include <string.h>
#include <stdlib.h>

#define PIN_BRIDGE_UART_TX 0
#define PIN_BRIDGE_UART_RX 1
#define PIN_BRIDGE_UART_CTS 2
#define PIN_BRIDGE_UART_RTS 3

#define BRIDGE_BAUD_RATE 115200

PacketBuffer rx_packets[N_RX_PACKET_BUFFERS];
volatile PacketBuffer *rx_packet = rx_packets;
PacketBuffer *processed_rx_packet = rx_packets;

int dma_ch_rx_header = -1;
int dma_ch_rx_payload = -1;
int dma_ch_tx = -1;

void ax08_bridge_init_rx_header() {
    dma_channel_config config = dma_channel_get_default_config(dma_ch_rx_header);
    channel_config_set_transfer_data_size(&config, DMA_SIZE_8);
    channel_config_set_read_increment(&config, false);
    channel_config_set_write_increment(&config, true);
    channel_config_set_dreq(&config, DREQ_UART0_RX);

    dma_channel_configure(
        dma_ch_rx_header,
        &config,
        rx_packet,
        &uart_get_hw(uart0)->dr,
        BRIDGE_PACKET_HEADER_SIZE,
        false
    );

    // Clear any remaining interupts.
    dma_irqn_acknowledge_channel(1, dma_ch_rx_header);
    dma_channel_start(dma_ch_rx_header);
}

void ax08_bridge_init_rx_payload(uint32_t size) {
    dma_channel_config config = dma_channel_get_default_config(dma_ch_rx_payload);
    channel_config_set_transfer_data_size(&config, DMA_SIZE_8);
    channel_config_set_read_increment(&config, false);
    channel_config_set_write_increment(&config, true);
    channel_config_set_dreq(&config, DREQ_UART0_RX);

    dma_channel_configure(
        dma_ch_rx_payload,
        &config,
        rx_packet->data,
        &uart_get_hw(uart0)->dr,
        size,
        false
    );

    // Clear any remaining interupts.
    dma_irqn_acknowledge_channel(1, dma_ch_rx_payload);
    dma_channel_start(dma_ch_rx_payload);
}

void ax08_bridge_handle_rx_header() {
    // Get the size of the packet.
    uint32_t size = rx_packet->size;

    // Check that the size of the packet is valid.
    if (size == 0 || size > MAX_PACKET_PAYLOAD_SIZE) {
        ax08_bridge_init_rx_header();
        return;
    }

    // Initialize bridge to receive the payload.
    ax08_bridge_init_rx_payload(size);
}

void ax08_bridge_handle_rx_payload() {
    // Increment packet pointer.
    rx_packet += 1;
    if (rx_packet >= rx_packets + N_RX_PACKET_BUFFERS) {
        rx_packet = rx_packets;
    }

    // Initialize bridge to receive the next header.
    ax08_bridge_init_rx_header();
}

void ax08_bridge_dma_irq1_handler() {
    // Check if packet header was received.
    if (dma_irqn_get_channel_status(1, dma_ch_rx_header)) {
        ax08_bridge_handle_rx_header();
        dma_irqn_acknowledge_channel(1, dma_ch_rx_header);
    }

    // Check if packet payload was received.
    if (dma_irqn_get_channel_status(1, dma_ch_rx_payload)) {
        ax08_bridge_handle_rx_payload();
        dma_irqn_acknowledge_channel(1, dma_ch_rx_payload);
    }
}

void ax08_bridge_protocol_init() {
    uart_init(uart0, BRIDGE_BAUD_RATE);

    // Set the TX and RX pins by using the function select on the GPIO
    // Set datasheet for more information on function select
    gpio_set_function(PIN_BRIDGE_UART_TX, GPIO_FUNC_UART); // UART0 TX
    gpio_set_function(PIN_BRIDGE_UART_RX, GPIO_FUNC_UART); // UART0 RX
    gpio_set_function(PIN_BRIDGE_UART_CTS, GPIO_FUNC_UART); // UART0 CTS (Clear To Send, Pico INPUT, active low)
    gpio_set_function(PIN_BRIDGE_UART_RTS, GPIO_FUNC_UART); // UART0 RTS (Request To Send, Pico OUTPUT, active low)

    // Configure uart.
    uart_set_fifo_enabled(uart0, true);
    uart_set_hw_flow(uart0, true, true);

    // Claim dma channels.
    dma_ch_rx_header = dma_claim_unused_channel(true);
    dma_ch_rx_payload = dma_claim_unused_channel(true);
    dma_ch_tx = dma_claim_unused_channel(true);

    // Configure the rx channels to raise the dma-interrupt-1
    dma_irqn_set_channel_enabled(1, dma_ch_rx_header, true);
    dma_irqn_set_channel_enabled(1, dma_ch_rx_payload, true);

    // Enable the DMA IRQ 1 interrupt.
    irq_set_exclusive_handler(DMA_IRQ_1, ax08_bridge_dma_irq1_handler);
    irq_set_enabled(DMA_IRQ_1, true);

    // Initialize state machine.
    ax08_bridge_init_rx_header();
}

PacketBuffer* ax08_bridge_read_packet() {
    // Check if a new packet was received, otherwise, return nullptr.
    if (processed_rx_packet == rx_packet) {
        return NULL;
    }

    PacketBuffer *received_packet = processed_rx_packet;

    // Increment processed packet pointer.
    processed_rx_packet += 1;
    if (processed_rx_packet >= rx_packets + N_RX_PACKET_BUFFERS) {
        processed_rx_packet = rx_packets;
    }

    // Return the address packet.
    return received_packet;
}

void ax08_bridge_packet_update_sha256(PacketBuffer *buffer) {
    pico_sha256_state_t state;
    int result = pico_sha256_start_blocking(&state, SHA256_BIG_ENDIAN, true);
    hard_assert(result == PICO_OK);
    pico_sha256_update_blocking(&state, buffer->data - 4, buffer->size + 4); // Also hash size field.
    pico_sha256_finish(&state, &buffer->hash);
}

void ax08_bridge_send_packet(const PacketBuffer *buffer) {
    dma_channel_config channel_config = dma_channel_get_default_config(dma_ch_tx);
    channel_config_set_transfer_data_size(&channel_config, DMA_SIZE_8);
    channel_config_set_dreq(&channel_config, DREQ_UART0_TX);
    channel_config_set_read_increment(&channel_config, true);
    channel_config_set_write_increment(&channel_config, false);

    dma_channel_configure(
        dma_ch_tx,
        &channel_config,
        &uart_get_hw(uart0)->dr,
        buffer,
        buffer->size + sizeof(uint32_t) + sizeof(sha256_result_t),
        true
    );

    dma_channel_wait_for_finish_blocking(dma_ch_tx);
}

void ax08_bridge_packet_init_reader(const PacketBuffer *buffer, BufferReader *reader) {
    reader->data = buffer->data;
    reader->size = buffer->size;
    reader->index = 0;
}

void ax08_bridge_packet_init_writer(PacketBuffer *buffer, BufferWriter *writer) {
    writer->data = buffer->data;
    writer->size = MAX_PACKET_PAYLOAD_SIZE;
    writer->index = 0;
}

void ax08_bridge_packet_close_writer(PacketBuffer *buffer, const BufferWriter *writer) {
    buffer->size = writer->index;
}
