VoxelPi/AX08/tools/scripts/uart_ddos.py

import math
import serial
import serial.tools.list_ports
import time

print("Available Ports:")
ports = serial.tools.list_ports.comports()
for port in ports:
    print(f"  - {port.device}: {port.description}")

bridge_port = serial.Serial("COM7", 115200, rtscts=True)

data = bytearray()

# for i in range(100):
#     bridge_port.write(b"\x00")
#     time.sleep(0.5)
#     bridge_port.write(b"\xFF")
#     time.sleep(0.5)


# bridge_port.write(b"Lorem ipsum dolor sit amet, consectetur adipiscing elit, sed do eiusmod tempor incididunt ut labore et dolore magna aliqua. Ut enim ad minim veniam, quis nostrud exercitation ullamco laboris nisi ut aliquip ex ea commodo consequat. Duis aute irure dolor in reprehenderit in voluptate velit esse cillum dolore eu fugiat nulla pariatur. Excepteur sint occaecat cupidatat non proident, sunt in culpa qui officia deserunt mollit anim id est laborum.")

for i in range(100000):
    # duty_cycle = (1 + math.sin(i*2*math.pi/200)) / 2
    duty_cycle = (1 + 1.1*math.sin(i*2*math.pi/200)) / 2

    start_time = time.time()
    frame_end_time = start_time + 0.02

    if duty_cycle >= 1.0:
        bridge_port.write(b"\xFF")
        # time.sleep(0.02)
    elif duty_cycle <= 0.0:
        bridge_port.write(b"\x00")
        # time.sleep(0.02)
    else:
        duty_change_time = start_time + 0.02*duty_cycle
        bridge_port.write(b"\xFF")
        # time.sleep(duty_cycle * 0.02)
        while time.time() < duty_change_time:
            ...
        bridge_port.write(b"\x00")
        # time.sleep((1 - duty_cycle) * 0.02)

    while time.time() < frame_end_time:
        ...

# bridge_port.write(b"\x00\xFF\x00\xFF\x00\xFF\x00\xFF\x00\xFF\x00\xFF\x00\xFF\x00\xFF\x00\xFF\x00\xFF\x00\xFF\x00\xFF\x00\xFF\x00\xFF\x00\xFF\x00\xFF\x00\xFF\x00\xFF\x00\xFF\x00\xFF\x00\xFF\x00\xFF\x00\xFF\x00\xFF\x00\xFF\x00\xFF\x00\xFF\x00\xFF\x00\xFF\x00\xFF\x00\xFF\x00\xFF\x00\xFF\x00\xFF\x00\xFF\x00\xFF\x00\xFF\x00\xFF\x00\xFF\x00\xFF\x00\xFF\x00\xFF\x00\xFF\x00\xFF\x00\xFF\x00\xFF\x00\xFF\x00\xFF\x00\xFF\x00\xFF\x00\xFF\x00\xFF\x00\xFF\x00\xFF\x00\xFF\x00\xFF\x00\xFF\x00\xFF\x00\xFF\x00\xFF\x00\xFF\x00\xFF\x00\xFF\x00\xFF\x00\xFF\x00\xFF\x00\xFF\x00\xFF\x00\xFF\x00\xFF\x00\xFF\x00\xFF\x00\xFF\x00\xFF\x00\xFF\x00\xFF\x00\xFF\x00\xFF\x00\xFF\x00\xFF\x00\xFF\x00\xFF\x00\xFF\x00\xFF\x00\xFF\x00\xFF\x00\xFF\x00\xFF\x00\xFF\x00\xFF\x00\xFF\x00\xFF\x00\xFF\x00\xFF\x00\xFF\x00\xFF\x00\xFF\x00\xFF\x00\xFF\x00\xFF\x00\xFF\x00\xFF\x00\xFF\x00\xFF\x00\xFF\x00\xFF\x00\xFF\x00\xFF\x00\xFF\x00\xFF\x00\xFF\x00\xFF\x00\xFF\x00\xFF\x00\xFF\x00\xFF\x00\xFF\x00\xFF\x00\xFF\x00\xFF\x00\xFF\x00\xFF\x00\xFF\x00\xFF\x00\xFF\x00\xFF\x00\xFF\x00\xFF\x00\xFF\x00\xFF\x00\xFF\x00\xFF\x00\xFF\x00\xFF\x00\xFF\x00\xFF\x00\xFF\x00\xFF\x00\xFF\x00\xFF\x00\xFF\x00\xFF\x00\xFF\x00\xFF\x00\xFF\x00\xFF\x00\xFF\x00\xFF\x00\xFF\x00\xFF\x00\xFF\x00\xFF\x00\xFF\x00\xFF\x00\xFF\x00\xFF\x00\xFF\x00\xFF\x00\xFF\x00\xFF\x00\xFF\x00\xFF\x00\xFF\x00\xFF\x00\xFF\x00\xFF\x00\xFF\x00\xFF\x00\xFF\x00\xFF\x00\xFF\x00\xFF\x00\xFF\x00\xFF\x00\xFF\x00\xFF\x00\xFF\x00\xFF\x00\xFF\x00\xFF\x00\xFF\x00\xFF\x00\xFF\x00\xFF\x00\xFF\x00\xFF\x00\xFF\x00\xFF\x00\xFF\x00\xFF\x00\xFF\x00\xFF\x00\xFF\x00\xFF\x00\xFF\x00\xFF\x00\xFF\x00\xFF\x00\xFF\x00\xFF\x00\xFF\x00\xFF\x00\xFF\x00\xFF\x00\xFF\x00\xFF\x00\xFF\x00\xFF\x00\xFF\x00\xFF\x00\xFF\x00\xFF\x00\xFF\x00\xFF\x00\xFF\x00\xFF\x00\xFF\x00\xFF\x00\xFF\x00\xFF\x00\xFF\x00\xFF\x00\xFF\x00\xFF\x00\xFF\x00\xFF\x00\xFF\x00\xFF\x00\xFF\x00\xFF\x00\xFF\x00\xFF\x00\xFF\x00\xFF\x00\xFF\x00\xFF\x00\xFF\x00\xFF\x00\xFF\x00\xFF\x00\xFF\x00\xFF\x00\xFF\x00\xFF\x00\xFF\x00\xFF\x00\xFF\x00\xFF\x00\xFF\x00\xFF\x00\xFF\x00\xFF\x00\xFF\x00\xFF\x00\xFF\x00\xFF\x00\xFF\x00\xFF\x00\xFF\x00\xFF\x00\xFF\x00\xFF\x00\xFF\x00\xFF\x00\xFF\x00\xFF\x00\xFF\x00\xFF\x00\xFF\x00\xFF\x00\xFF\x00\xFF\x00\xFF\x00\xFF\x00\xFF\x00\xFF\x00\xFF\x00\xFF\x00\xFF\x00\xFF\x00\xFF\x00\xFF\x00\xFF\x00\xFF\x00\xFF\x00\xFF\x00\xFF\x00\xFF\x00\xFF\x00\xFF\x00\xFF\x00\xFF\x00\xFF\x00\xFF\x00\xFF\x00\xFF\x00\xFF\x00\xFF\x00\xFF\x00\xFF\x00\xFF\x00\xFF\x00\xFF\x00\xFF\x00\xFF\x00\xFF\x00\xFF\x00\xFF\x00\xFF\x00\xFF\x00\xFF\x00\xFF\x00\xFF\x00\xFF\x00\xFF\x00\xFF\x00\xFF\x00\xFF\x00\xFF\x00\xFF\x00\xFF\x00\xFF\x00\xFF\x00\xFF\x00\xFF\x00\xFF\x00\xFF\x00\xFF\x00\xFF\x00\xFF\x00\xFF\x00\xFF\x00\xFF\x00\xFF\x00\xFF\x00\xFF\x00\xFF\x00\xFF\x00\xFF\x00\xFF\x00\xFF\x00\xFF\x00\xFF\x00\xFF\x00\xFF\x00\xFF\x00\xFF\x00\xFF\x00\xFF\x00\xFF\x00\xFF\x00\xFF\x00\xFF\x00\xFF\x00\xFF\x00\xFF\x00\xFF\x00\xFF\x00\xFF\x00\xFF")
bridge_port.close()
