VoxelPi/AX08/(commit log)

2025-06-16 Added instruction set specification
    [ax08.xlsx]
2025-06-16 Add memory index register
    [ax08.xlsx]
2025-06-16 added schematics, updated part estimate
    [part count estimates.xlsx]
2025-06-16 Update specification
    [ax08.xlsx]
2025-06-18 Update specification again
    [ax08.xlsx]
2025-06-18 Update part list
    [part count estimates.xlsx]
2025-06-18 Add baud rate docs
    [ax08.xlsx]
2025-06-18 added parts for breadboard version
    [part count estimates.xlsx]
2025-06-18 added initial orders
    [part count estimates.xlsx]
2025-06-18 added easyeda ax08 project
    [ax08.eprj]
2025-06-18 fixed pc pseudoschematic
    [ax08.eprj]
2025-06-18 Add page register
    [ax08.xlsx]
2025-06-19 added unit interface documentation
    [ax08.xlsx, unit interface.xlsx]
2025-06-19 added pc schematic
    [ax08.eprj, unit interface.xlsx]
2025-06-19 Document memory space
    [ax08.xlsx]
2025-06-19 Add schematic for condition unit
    [ax08_duplicate.eprj]
2025-06-19 updated pc schematic
    [ax08.eprj, ax08.xlsx, unit interface.xlsx]
2025-06-19 updated pc routing
    [ax08.eprj, unit interface.xlsx]
2025-06-20 finalised pc layout, fixed condition unit bug
    [ax08.eprj, unit interface.xlsx]
2025-06-21 connected pc and reg in layout
    [ax08.eprj]
2025-06-22 Cleanup documentation
    [ax08.xlsx]
2025-06-22 Small updates
    [ax08.xlsx]
2025-06-22 added memory interface to schematics
    [ax08.eprj, unit interface.xlsx]
2025-06-22 fixed RGSET faulty schematic connection
    [ax08.eprj, ax08.xlsx]
2025-06-22 Ignore easyeda backups
    [ax08_duplicate.eprj]
2025-06-23 added output address selector, updated decode unit placement
    [ax08.eprj]
2025-06-25 corrected hardware clock cycle documentation
    [ax08.eprj, ax08.xlsx]
2025-06-25 rearranged decode unit
    [ax08.eprj, ax08.xlsx, unit interface.xlsx]
2025-06-25 Use UART for IO module
    [ax08.xlsx]
2025-06-28 routed condition unit
    [ax08.eprj, ax08.xlsx, unit interface.xlsx]
2025-07-05 Added 8bit uart to parallel converter firmware
2025-07-05 Add running light test firmware for the debug boards
2025-07-05 Added 8bit parallel to uart converter firmware
2025-07-05 added general architecture master documentation (final)
    [ax08.xlsx]
2025-07-10 added ax08_lite opcodes
    [ax08.eprj, ax08.xlsx, unit interface.xlsx]
2025-07-10 updated pc address logic and decode unit wiring
    [ax08.eprj, ax08.xlsx]
2025-07-11 added hold unit, updated mem unit wiring
    [ax08.eprj, ax08.xlsx, unit interface.xlsx]
2025-07-11 added frontpanel, sequencer, opcode decoder, updated lite opcodes
    [ax08.eprj, ax08.xlsx, unit interface.xlsx]
2025-07-11 added opcode decoder, memory read unit
    [ax08.eprj, ax08.xlsx]
2025-07-12 prepared part order for peripherals
    [ax08.xlsx, part count estimates.xlsx, unit interface.xlsx]
2025-07-16 updated order estimate
    [ax08.eprj, part count estimates.xlsx, unit interface.xlsx]
2025-07-17 updated order estimate, fixed minor schematic opcode oopsies
    [ax08.xlsx, part count estimates.xlsx]
2025-07-18 finished component placement (lite)
    [ax08.xlsx, part count estimates.xlsx]
2025-08-04 finished load unit, changed units placement
    [ax08.eprj]
2025-08-05 added pc debug leds, finished opcode decoder
    [ax08.eprj]
2025-08-06 finished debug utils
    [ax08.eprj]
2025-08-10 Use correct uart baud rate
    [uart_ddos.py]
2025-08-11 finished wiring inner units, sequencer
    [ax08.eprj, unit interface.xlsx]
2025-08-12 finished wiring units
    [ax08.eprj]
2025-08-13 Added uart debug script
2025-08-13 finished wiring ax08lite
    [ax08.eprj]
2025-08-13 added copper fills, logo and description silkscreen
    [ax08.eprj]
2025-08-14 mem unit layout drafting
    [ax08.eprj]
2025-08-15 Claim dma channel on init
2025-08-15 Move uart0 code to bridge protocol
2025-08-16 mem IC placement, upper PIC routing
    [ax08.eprj]
2025-08-16 Add uart pio state machine programs
2025-08-16 finished mem unit wiring, fixed sussy resistors
    [ax08.eprj]
2025-08-16 Implemented memory unit (but it doesn't work)
    Also implemented a merge conflict
    [memory_unit.c]
2025-08-17 Add missing loop in mem unit code
    [memory_unit.c, uart_debug.py]
2025-08-17 fixed mem unit wiring
    [ax08.eprj]
2025-08-17 fixed weird pad wiring, finished mem/lite v1
    [ax08.eprj, part count estimates.xlsx]
2025-08-20 Document sequencer bridge protocol
    [ax08.xlsx]
2025-08-21 Fix typo in uart debug script
    [uart_debug.py]
2025-08-21 Small modifications to the bridge-sequencer protocol
    [ax08.xlsx]
2025-08-21 Added Arbeitszeiten excel
    [zeiten.xlsx]
2025-08-21 fixed excel format 🥶
    [zeiten.xlsx]
2025-08-25 added sequencer schematic, pin doc
    [ax08.eprj, zeiten.xlsx]
2025-08-27 finished sequencer layout
    [ax08.eprj, zeiten.xlsx]
2025-08-28 finished io unit and frontpanel
    [ax08.eprj, zeiten.xlsx]
2025-08-28 sequencer goto hell 🥀
    [zeiten.xlsx]
2025-08-29 Added my ordered part
    [part count estimates.xlsx]
2025-08-29 peripherals review and order
    [ax08.eprj, part count estimates.xlsx, zeiten.xlsx]
2025-08-29 Add hours for protocol implementation
    [zeiten.xlsx]
2025-09-01 updated 🅱️roject management
    [zeiten.xlsx]
2025-09-01 updated first test times
    [zeiten.xlsx]
2025-09-02 updated times
    [zeiten.xlsx]
2025-09-02 Document stack pointer register
    [ax08.xlsx]
2025-09-02 ⌛ updated times
    [zeiten.xlsx]
2025-09-03 first tests, added silicon errate 🥶
    [zeiten.xlsx]
2025-09-04 Fix page write address
    [ax08.xlsx]
2025-09-04 Toggle on buildin pico led
2025-09-04 ⌛ ax08lite tests
    [zeiten.xlsx]
2025-09-05 ⌛Sequencer Breadboard
    [zeiten.xlsx]
2025-09-06 ⌛Optimize memory unit & sequencer
    [zeiten.xlsx]
2025-09-07 Use correct pio unit for memory data out
    [memory_unit.c]
2025-09-07 ⌛ Memory unit testing
    [zeiten.xlsx]
2025-09-07 Rewrite sequencer using timers and interrupts
2025-09-07 Configure sequencer UART module
2025-09-07 Implement sequencer reset logic
    [main.c]
2025-09-07 ⌛Integration tests
    [zeiten.xlsx]
2025-09-08 Fix reset mode of sequencer
    [main.c]
2025-09-08 Debounce mode pin in sequencer firmware
2025-09-08 Fix sequencer break opcode and skip store in break instruction
    [main.c]
2025-09-08 ⌛Sequencer optimizations
    [zeiten.xlsx]
2025-09-09 ⌛Time update
    [zeiten.xlsx]
2025-09-10 Use correct pio as dreq source for memory data out
    [memory_unit.c]
2025-09-10 ⌛minor bugfix (╯°□°）╯︵ ┻━┻
    [zeiten.xlsx]
2025-09-11 started ax08main
    [ax08.eprj, ax08.xlsx, zeiten.xlsx]
2025-09-11 Fix all floating pins, by using wpu / defining them as outputs
    [main.c]
2025-09-11 Use 4MHz uart clock for internal bridge communication
2025-09-12 ax08 main design
    [ax08.eprj, ax08.xlsx, zeiten.xlsx]
2025-09-14 Swap run step & run instruction pins
    [main.c]
2025-09-14 Assign flow control pins on bridge to sequencer port
2025-09-15 ax08main decode and logic unit
    [ax08.eprj, ax08.xlsx]
2025-09-15 ⌛ time update
    [zeiten.xlsx]
2025-09-17 carry unit sanity checking
    [ax08.eprj]
2025-09-18 ax08 main design (carry unit)
    [ax08.eprj]
2025-09-18 ax08 main design (carry unit, opcode logic)
    [ax08.eprj]
2025-09-19 finished ax08 main wiring
    [ax08.eprj]
2025-09-19 finalized ax08main
    [ax08.eprj]
2025-09-21 ax08 main review and order
    [ax08.eprj, part count estimates.xlsx]
2025-09-23 frontpanel v2 schematic and design
    [ax08.eprj]
2025-09-23 ⌛ time upd🅰te
    [zeiten.xlsx]
2025-09-24 finished frontpanel v2
    [ax08.eprj]
2025-09-25 frontpanel v2 order preparation
    [ax08.eprj]
2025-09-25 added frontpanel orders
    [part count estimates.xlsx]
2025-09-28 Add case cad files
    [case_back.prt, case_left.prt, case_right.prt, din912.prt, front_bottom.prt, frontpanel_backplate.prt, lid_frame_back.prt, lid_frame_front.prt]
2025-10-03 EDA file cleanup
    [ax08.eprj]
2025-10-04 added documentation version of EDA project
    [ax08_doc.eprj]
2025-10-04 Add tray and bracket for ax08 to case
    [ax08_bracket.prt, ax08_tray.prt, cable_holder.prt, cable_holder_test.prt, case_left.prt, case_right.prt, prt0005.prt]
2025-10-05 Added cable anchors to case
    [cable_anchor_v2.prt, cable_holder_test.prt, case_back.prt, case_left.prt, case_right.prt]
2025-10-05 updated ax08main to documentation standard
    [ax08_doc.eprj]
2025-10-07 Update case
    [ax08_bracket.prt, ax08_tray.prt, case_left.prt, case_right.prt, front_bottom.prt, frontpanel_backplate.prt]
2025-10-09 ⌛time update - ax08 main production
    [zeiten.xlsx]
2025-10-13 Fix RTS initial state
    [main.c]
2025-10-13 Fix MCLR enable config word
    [main.c]
2025-10-13 ⌛ time update - ax08 integration
    [zeiten.xlsx]
2025-10-14 Small adjustments to the case in response to the integration tests
    [frontpanel_backplate.prt, lid_frame_back.prt, lid_frame_front.prt, lid_frame_left.prt, lid_glass.prt]
2025-10-14 Add cutting template for the lid glass plate
    [lid_glass_cut_template.prt]
2025-10-15 ⌛ time update - cables
    [zeiten.xlsx]
2025-10-17 ⌛ time update - peripherals assembly
    [zeiten.xlsx]
2025-10-24 Small updates to case 0.1.1
    [ax08_bracket.prt, ax08_tray.prt, case_back.prt, case_left.prt, case_right.prt, front_bottom.prt, frontpanel_backplate.prt, lid_frame_right.prt]
2025-10-24 Fix UART TX interrupt
    [main.c]
2025-10-24 Print firmware version on startup
2025-10-26 fixed ax08 sequencing issue (missing reset step)
    [ax08.xlsx]
2025-10-26 Don't skip reset cycle state in run state
    A gap is needed between the store and the next freeze word steps
    [main.c]
2025-11-03 Clear hold line when the opcode is freezed
    [ax08.xlsx]
2025-11-03 Sequencer ⏰ Fix missing state timer enable on state switch
    [main.c]
2025-11-03 Sequencer ⏰ Add 1kHz clock mode
2025-11-03 Sequencer ⏰ Enable compiler optimizations
2025-11-03 Sequencer ⏰ Delay clear of hold line
2025-11-03 IO Unit ✉️ Use falling edge of hold line for synchronization
2025-11-04 Bridge 🌉 Allow custom default program.
2025-11-05 Sequencer ⏰ Fix resume from break in turbo state
    [main.c]
2025-11-05 Sequencer ⏰ Fix break instruction in turbo mode (for real this time!)
    Enable the state timer when switching to the idle state because of a break instruction.
    [main.c]
2025-11-06 Sequencer ⏰ Revert changes to hold line and improve timings
    This fixes a bug with the carry unit
    [ax08.xlsx]
2025-11-06 IO Unit ✉️ Update to use latest sequencer protocol
2025-11-06 Sequencer ⏰Update documentation on non turbo clock speeds
2025-11-07 Sequencer ⏰Increase duration of store pulse in turbo mode
2025-12-11 finalized orders 1 tab
    [part count estimates.xlsx]
2026-02-02 Sequencer ⏰ Update mplab config
2026-02-03 IO Unit ✉️ Update mplab config
2026-02-03 Use EEPROM for state timer config
2026-02-22 Added reset timer for commands
    [command.c, command.h, main.c]
2026-02-22 Some style & documentation fixes
    [command.c, main.c]
2026-02-22 Don't disable interrupts during command processing
2026-02-22 Configure a uart baud rate of 115200
2026-02-22 Fix number of issues found in testing
    [command.c, main.c]
2026-02-23 Don't disable interrupts in turbo mode
2026-02-23 Fix incorrect loop for config upload
    [command.c]
2026-11-06 Actually update hw timer config & speed
2026-11-06 Send number of timer configurations on data query
2026-11-06 Respond with correct hw timer period in state response
